lhr-solar/BPS-Leader/Hardware/ArrPreContactor.kicad_sch

## KiCad design Hardware/ArrPreContactor.kicad_sch (2026-01-18)

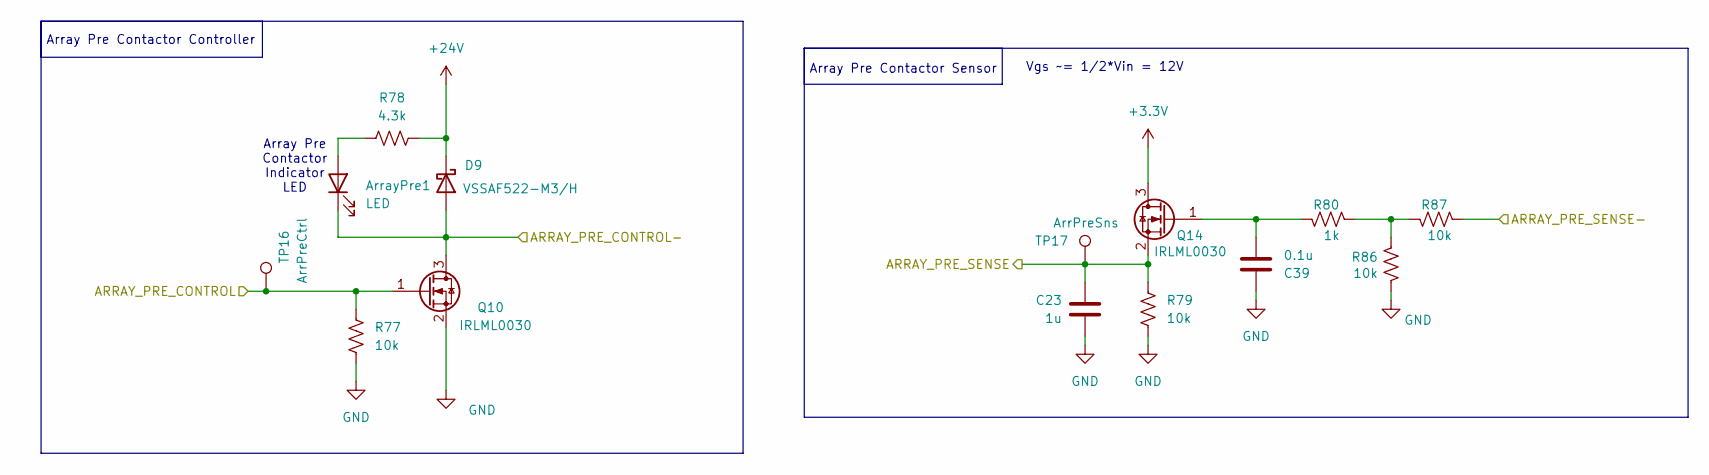
[picture p1: schematic ArrPreContactor.kicad_sch]

Parts:
ArrayPre1: LED; LED_0603_1608Metric; LCSC C84263
C23: 1u; C_0603_1608Metric; Mouser Part Number 963-UMK107BJ105KA-T
C39: 0.1u; C_0603_1608Metric; Mouser Part Number 963-HMK107B7104KA-T
D9: VSSAF522-M3/H; SODFL5226X100N; LCSC C6326606
Q10, Q14: IRLML0030; SOT-23; LCSC C67272
R77, R79, R86, R87: 10k; R_0603_1608Metric; LCSC C25804
R78: 4.3k; R_0603_1608Metric; LCSC C2907165
R80: 1k; R_0603_1608Metric; LCSC C21190
TP16: ArrPreCtrl; TestPoint_Pad_1.0x1.0mm
TP17: ArrPreSns; TestPoint_Pad_1.0x1.0mm

Connections:
+3.3V: Q14.3 (D)
+24V: D9.1 (K), R78.2
ARRAY_PRE_CONTROL: Q10.1 (G), R77.2, TP16.1
ARRAY_PRE_CONTROL-: ArrayPre1.1 (K), D9.2 (A), Q10.3 (D)
ARRAY_PRE_SENSE: C23.2, Q14.2 (S), R79.1, TP17.1
ARRAY_PRE_SENSE-: R87.2
GND: C23.1, C39.1, Q10.2 (S), R77.1, R79.2, R86.1
unnamed: ArrayPre1.2 (A), R78.1
unnamed: C39.2, Q14.1 (G), R80.1
unnamed: R80.2, R86.2, R87.1

Notes on the sheet:
Vgs ~= 1/2*Vin = 12V
Array Pre Contactor Controller
Array Pre Contactor Indicator LED
Array Pre Contactor Sensor
