lhr-solar/BPS-Leader/Hardware/Arr_Contactor.kicad_sch

## KiCad design Hardware/Arr_Contactor.kicad_sch (2026-01-18)

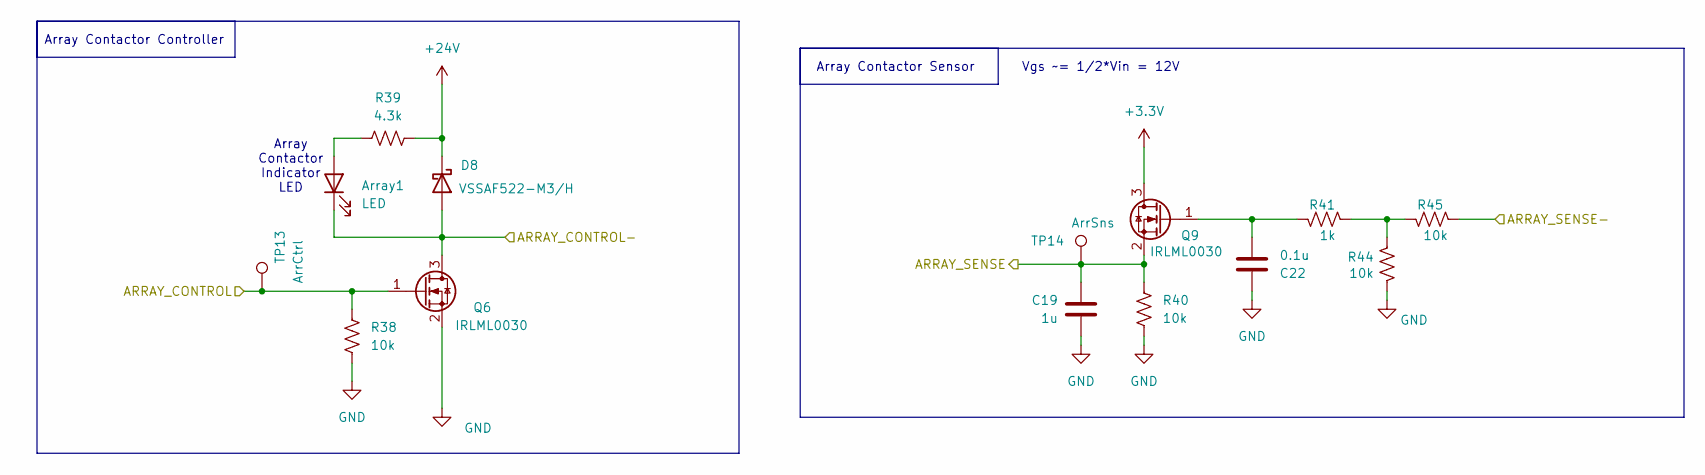
[picture p2: schematic Arr_Contactor.kicad_sch]

Parts:
Array1: LED; LED_0603_1608Metric; LCSC C84263
C19: 1u; C_0603_1608Metric; Mouser Part Number 963-UMK107BJ105KA-T
C22: 0.1u; C_0603_1608Metric; Mouser Part Number 963-HMK107B7104KA-T
D8: VSSAF522-M3/H; TO-247-2_Vertical; LCSC C6326606
Q6, Q9: IRLML0030; SOT-23; LCSC C67272
R38, R40, R44, R45: 10k; R_0603_1608Metric; LCSC C25804
R39: 4.3k; R_0603_1608Metric; LCSC C2907165
R41: 1k; R_0603_1608Metric; LCSC C21190
TP13: ArrCtrl; TestPoint_Pad_1.0x1.0mm
TP14: ArrSns; TestPoint_Pad_1.0x1.0mm

Connections:
+3.3V: Q9.3 (D)
+24V: D8.1 (K), R39.2
ARRAY_CONTROL: Q6.1 (G), R38.2, TP13.1
ARRAY_CONTROL-: Array1.1 (K), D8.2 (A), Q6.3 (D)
ARRAY_SENSE: C19.2, Q9.2 (S), R40.1, TP14.1
ARRAY_SENSE-: R45.2
GND: C19.1, C22.1, Q6.2 (S), R38.1, R40.2, R44.1
unnamed: Array1.2 (A), R39.1
unnamed: C22.2, Q9.1 (G), R41.1
unnamed: R41.2, R44.2, R45.1

Notes on the sheet:
Array Contactor Sensor
Vgs ~= 1/2*Vin = 12V
Array Contactor Controller
Array Contactor Indicator LED
