lhr-solar/BPS-Leader/Hardware/BPS-Leader.kicad_sch

## KiCad design Hardware/BPS-Leader.kicad_sch (2026-01-18)

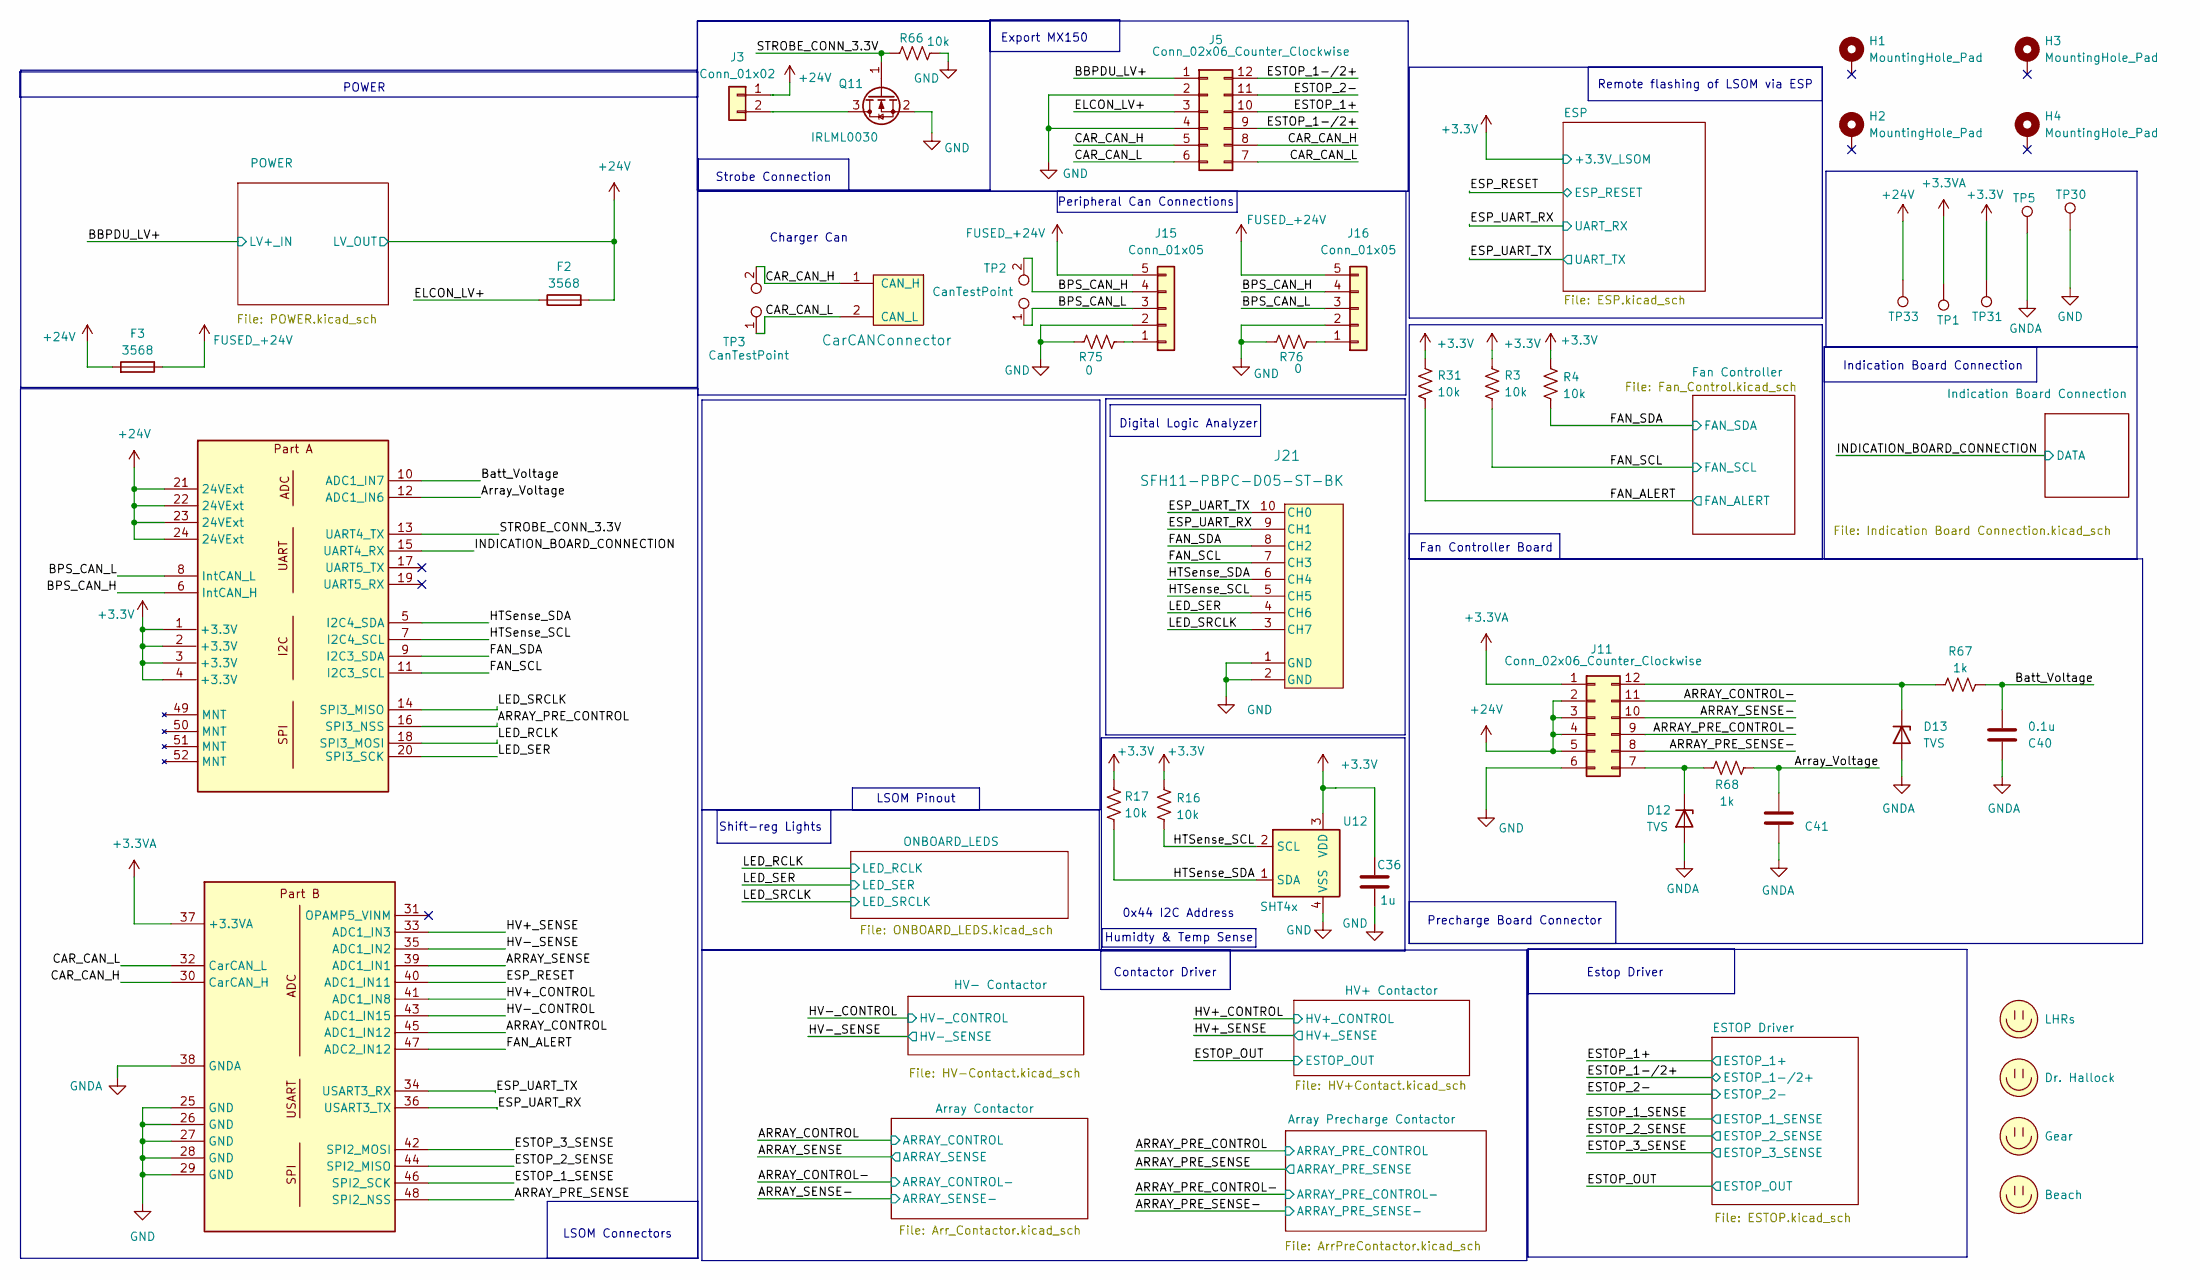
[picture p3: schematic BPS-Leader.kicad_sch]

Parts:
C36: 1u; C_0603_1608Metric; LCSC C15849
C40, C41: 0.1u; C_0603_1608Metric; Mouser Part Number 963-HMK107B7104KA-T
D12, D13: TVS; D_SOD-123F; Mouser Part Number 576-SMF3.3
F2, F3: 3568; LCSC C5249699
H1, H2, H3, H4: MountingHole_Pad; MountingHole_3.2mm_M3_Pad_TopBottom
J1: LeaderSOM
J3: Conn_01x02; Molex_Nano-Fit_105313-xx02_1x02_P2.50mm_Horizontal
J5, J11: Conn_02x06_Counter_Clockwise; Molex_Nano-Fit_105310-xx12_2x06_P2.50mm_Vertical
J8: CarCANConnector; Molex_Nano-Fit_105309-xx02_1x02_P2.50mm_Vertical
J15, J16: Conn_01x05; Molex_Nano-Fit_105309-xx05_1x05_P2.50mm_Vertical
J21: SFH11-PBPC-D05-ST-BK; CONN_SFH11-xxxC-D05-ST-XX_SUL
LOGO1: LHRs; LHRs_LOGO
LOGO2: Dr. Hallock; Hallock_Image
LOGO3: Beach
LOGO4: Gear
Q11: IRLML0030; SOT-23; LCSC C67272
R3, R4, R16, R17, R31, R66: 10k; R_0603_1608Metric; LCSC C25804
R67, R68: 1k; R_0603_1608Metric; Mouser Part Number 71-CRCW06031K00FKEI
R75, R76: 0; R_0603_1608Metric; LCSC C21189
TP1: +3.3VA; TestPoint_Keystone_5005-5009_Compact
TP2, TP3: CanTestPoint; PinHeader_1x02_P2.54mm_Vertical
TP5: GNDA; TestPoint_Keystone_5005-5009_Compact
TP30: GND; TestPoint_Keystone_5005-5009_Compact
TP31: +3.3V; TestPoint_Keystone_5005-5009_Compact
TP33: +24V; TestPoint_Keystone_5005-5009_Compact
U12: SHT4x; Sensirion_DFN-4_1.5x1.5mm_P0.8mm_SHT4x_NoCentralPad; LCSC C5221601

Connections:
+3.3V: C36.1, J1.1 (+3.3V), J1.2 (+3.3V), J1.3 (+3.3V), J1.4 (+3.3V), R3.1, R4.1, R16.1, R17.1, R31.1, TP31.1, U12.3 (VDD)
+3.3VA: J1.37 (+3.3VA), J11.1, TP1.1
+24V: F2.2, F3.2, J1.21 (24VExt), J1.22 (24VExt), J1.23 (24VExt), J1.24 (24VExt), J3.1, J11.2, J11.3, J11.4, J11.5, TP33.1
ARRAY_CONTROL: J1.45 (ADC1_IN12)
ARRAY_CONTROL-: J11.11
ARRAY_PRE_CONTROL: J1.16 (SPI3_NSS)
ARRAY_PRE_CONTROL-: J11.9
ARRAY_PRE_SENSE: J1.48 (SPI2_NSS)
ARRAY_PRE_SENSE-: J11.8
ARRAY_SENSE: J1.39 (ADC1_IN1)
ARRAY_SENSE-: J11.10
Array_Voltage: C41.2, J1.12 (ADC1_IN6), R68.1
BBPDU_LV+: J5.1
BPS_CAN_H: J1.6 (IntCAN_H), J15.4, J16.4, TP2.2
BPS_CAN_L: J1.8 (IntCAN_L), J15.3, J16.3, TP2.1
Batt_Voltage: C40.2, J1.10 (ADC1_IN7), R67.1
CAR_CAN_H: J1.30 (CarCAN_H), J5.5, J5.8, J8.1 (CAN_H), TP3.2
CAR_CAN_L: J1.32 (CarCAN_L), J5.6, J5.7, J8.2 (CAN_L), TP3.1
ELCON_LV+: F2.1, J5.3
ESP_RESET: J1.40 (ADC1_IN11)
ESP_UART_RX: J1.36 (USART3_TX), J21.9 (CH1)
ESP_UART_TX: J1.34 (USART3_RX), J21.10 (CH0)
ESTOP_1+: J5.10
ESTOP_1-/2+: J5.9, J5.12
ESTOP_1_SENSE: J1.46 (SPI2_SCK)
ESTOP_2-: J5.11
ESTOP_2_SENSE: J1.44 (SPI2_MISO)
ESTOP_3_SENSE: J1.42 (SPI2_MOSI)
FAN_ALERT: J1.47 (ADC2_IN12), R31.2
FAN_SCL: J1.11 (I2C3_SCL), J21.7 (CH3), R3.2
FAN_SDA: J1.9 (I2C3_SDA), J21.8 (CH2), R4.2
FUSED_+24V: F3.1, J15.5, J16.5
GND: C36.2, J1.25 (GND), J1.26 (GND), J1.27 (GND), J1.28 (GND), J1.29 (GND), J5.2, J5.4, J11.6, J15.2, J16.2, J21.1 (GND), J21.2 (GND), Q11.2 (S), R66.2, R75.1, R76.1, TP30.1, U12.4 (VSS)
GNDA: C40.1, C41.1, D12.2 (A), D13.2 (A), J1.38 (GNDA), TP5.1
HTSense_SCL: J1.7 (I2C4_SCL), J21.5 (CH5), R16.2, U12.2 (SCL)
HTSense_SDA: J1.5 (I2C4_SDA), J21.6 (CH4), R17.2, U12.1 (SDA)
HV+_CONTROL: J1.41 (ADC1_IN8)
HV+_SENSE: J1.33 (ADC1_IN3)
HV-_CONTROL: J1.43 (ADC1_IN15)
HV-_SENSE: J1.35 (ADC1_IN2)
INDICATION_BOARD_CONNECTION: J1.15 (UART4_RX)
LED_RCLK: J1.18 (SPI3_MOSI)
LED_SER: J1.20 (SPI3_SCK), J21.4 (CH6)
LED_SRCLK: J1.14 (SPI3_MISO), J21.3 (CH7)
unnamed: D12.1 (K), J11.7, R68.2
unnamed: D13.1 (K), J11.12, R67.2
unnamed: J3.2, Q11.3 (D)
unnamed: J15.1, R75.2
unnamed: J16.1, R76.2
STROBE_CONN_3.3V: J1.13 (UART4_TX), Q11.1 (G), R66.1

Notes on the sheet:
Contactor Driver
POWER
Estop Driver
Shift-reg Lights
Indication Board Connection
LSOM Pinout
Charger Can
Humidty & Temp Sense
Digital Logic Analyzer
Export MX150
Precharge Board Connector
0x44 I2C Address
Peripheral Can Connections
Remote flashing of LSOM via ESP
Strobe Connection
Fan Controller Board
LSOM Connectors
