lhr-solar/BPS-Leader/Hardware/Buttond_LEDs_IO.kicad_sch

## KiCad design Hardware/Buttond_LEDs_IO.kicad_sch (2026-01-18)

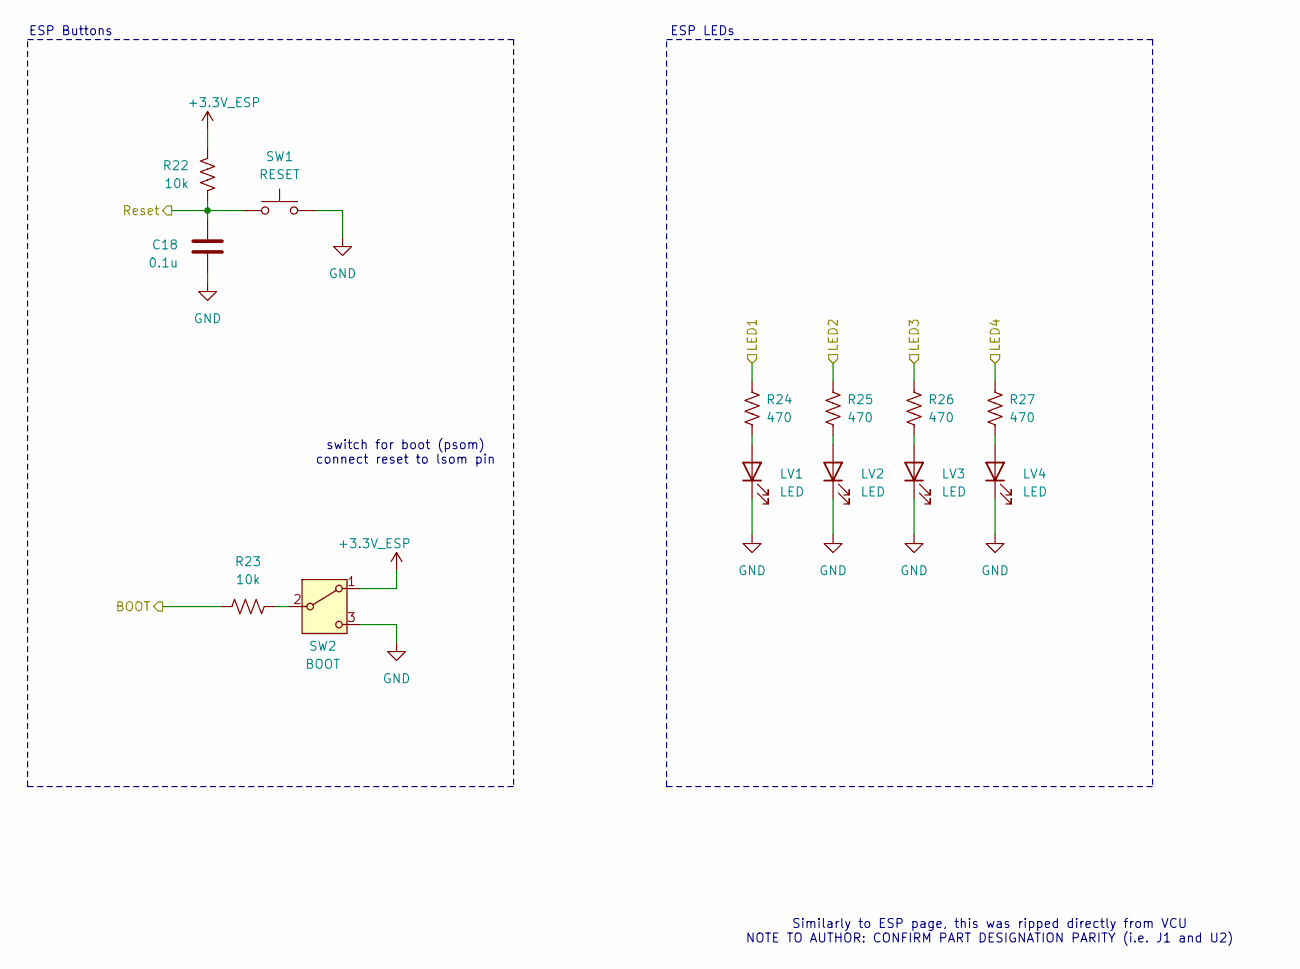
[picture p4: schematic Buttond_LEDs_IO.kicad_sch]

Parts:
C18: 0.1u; C_0603_1608Metric; LCSC C14663
LV1, LV2, LV3, LV4: LED; LED_0603_1608Metric; LCSC C7371904
R22, R23: 10k; R_0603_1608Metric; LCSC C25804
R24, R25, R26, R27: 470; R_0603_1608Metric; LCSC C23179
SW1: RESET; TL3365AF180QG; LCSC C2886926
SW2: BOOT; SW_CJS-1200TA; LCSC C2921628

Connections:
+3.3V_ESP: R22.1, SW2.1 (A)
BOOT: R23.2
GND: C18.2, LV1.1 (K), LV2.1 (K), LV3.1 (K), LV4.1 (K), SW1.1 (A), SW1.2 (A), SW2.3 (C)
LED1: R24.1
LED2: R25.1
LED3: R26.1
LED4: R27.1
unnamed: LV1.2 (A), R24.2
unnamed: LV2.2 (A), R25.2
unnamed: LV3.2 (A), R26.2
unnamed: LV4.2 (A), R27.2
unnamed: R23.1, SW2.2 (B)
Reset: C18.1, R22.2, SW1.3 (B), SW1.4 (B)

Notes on the sheet:
switch for boot (psom) connect reset to lsom pin
Similarly to ESP page, this was ripped directly from VCU NOTE TO AUTHOR: CONFIRM PART DESIGNATION PARITY (i.e. J1 and U2)
ESP Buttons
ESP LEDs
