lhr-solar/BPS-Leader/Hardware/ESP.kicad_sch

## KiCad design Hardware/ESP.kicad_sch (2026-01-18)

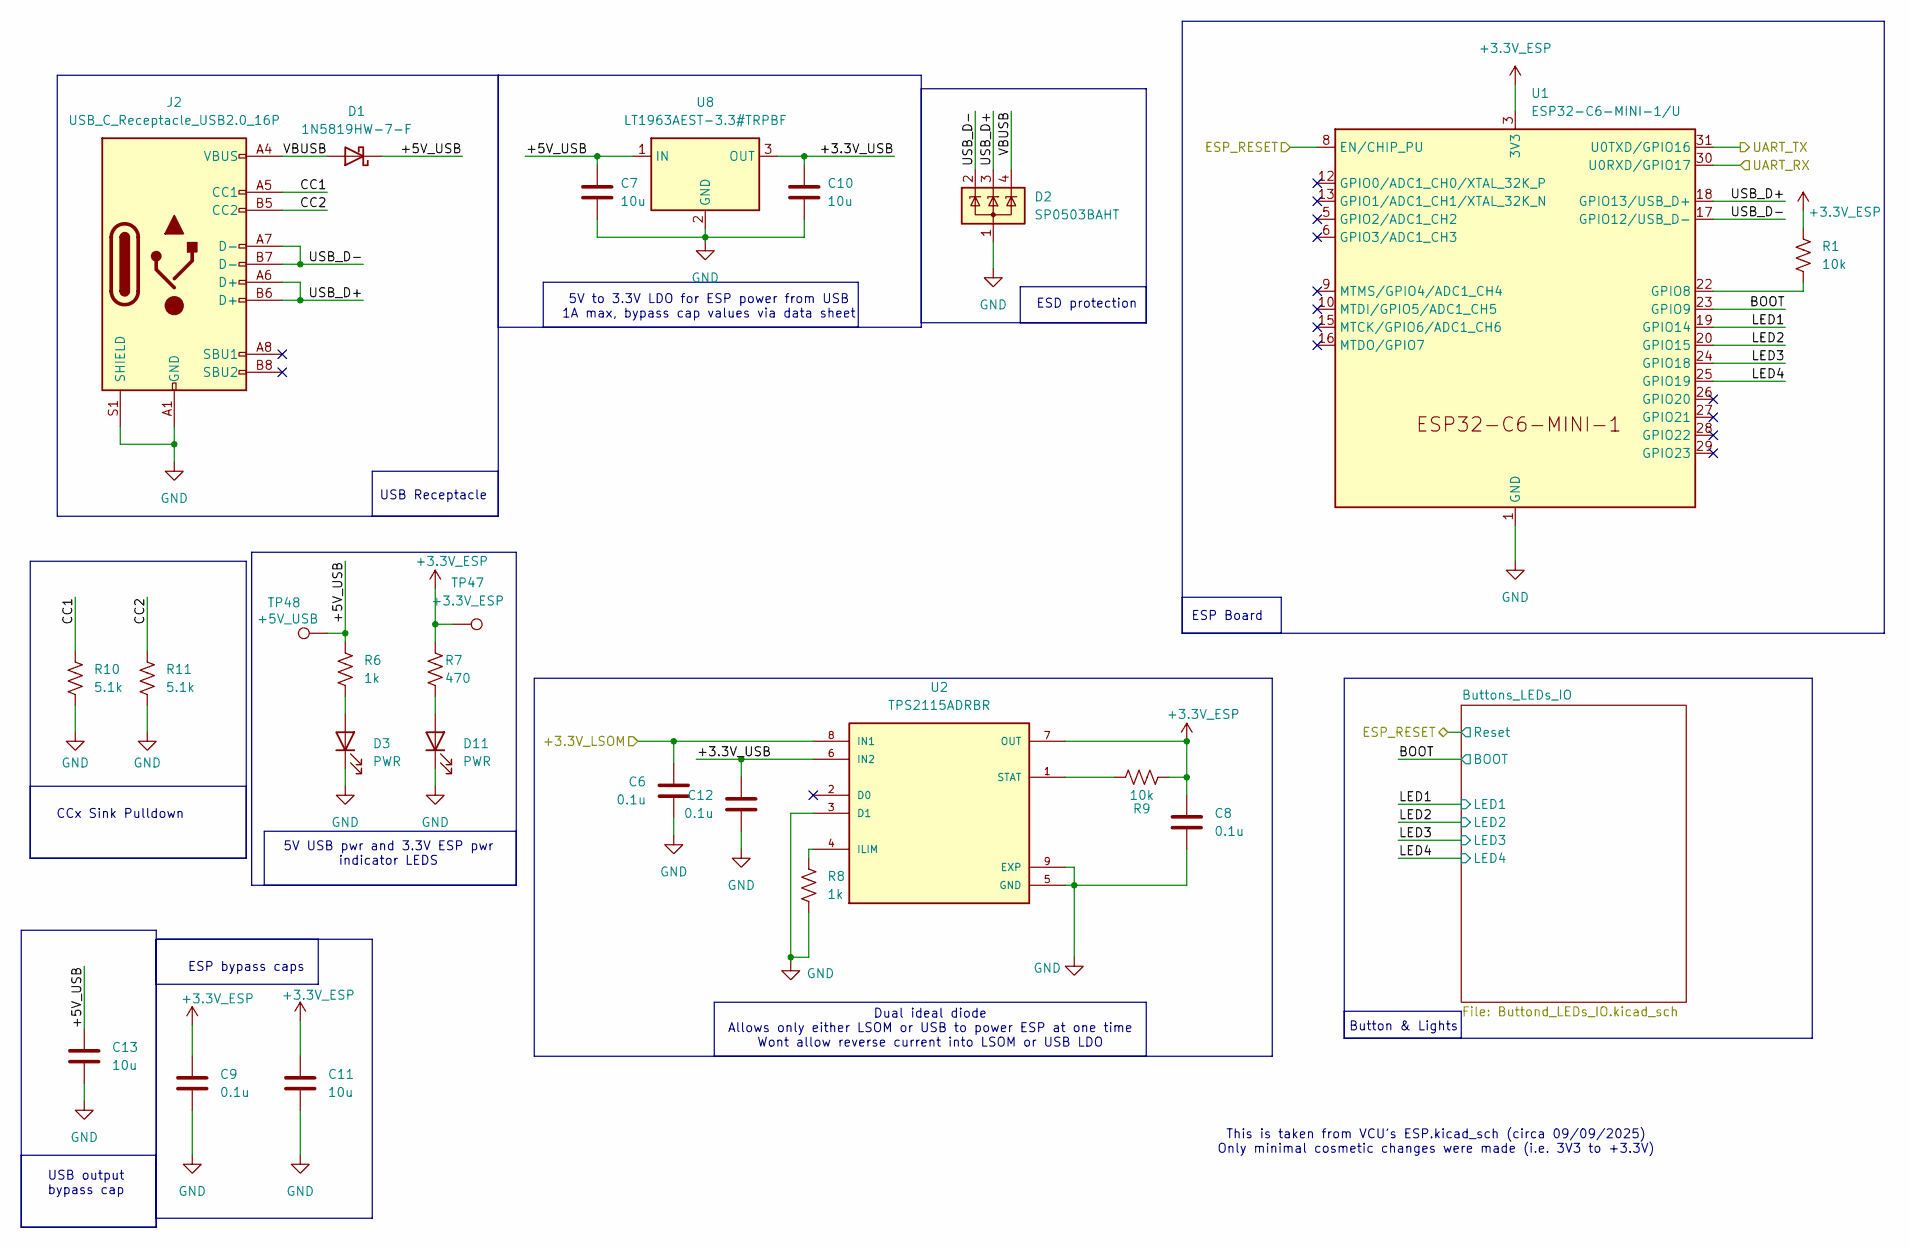
[picture p5: schematic ESP.kicad_sch]

Parts:
C6, C8, C9, C12: 0.1u; C_0603_1608Metric; LCSC C14663
C7, C10, C11, C13: 10u; C_0805_2012Metric; LCSC C440198
D1: 1N5819HW-7-F; D_SOD-123; LCSC C82544
D2: SP0503BAHT; SOT-143; Mouser Part Number 576-SP0503BAHTG
D3, D11: PWR; LED_0603_1608Metric; LCSC C7371904
J2: USB_C_Receptacle_USB2.0_16P; USB_C_Receptacle_GCT_USB4105-xx-A_16P_TopMnt_Horizontal; LCSC C393939
R1, R9: 10k; R_0603_1608Metric; LCSC C25804
R6, R8: 1k; R_0603_1608Metric; LCSC C21190
R7: 470; R_0603_1608Metric; LCSC C23179
R10, R11: 5.1k; R_0603_1608Metric; LCSC C23186
TP47: +3.3V_ESP; TestPoint_Keystone_5005-5009_Compact
TP48: +5V_USB; TestPoint_Keystone_5005-5009_Compact
U1: ESP32-C6-MINI-1/U; ESP32-C6-MINI-1; LCSC C5736265
U2: TPS2115ADRBR; SON65P300X300X100-9N; LCSC C140321
U8: LT1963AEST-3.3#TRPBF; SOT-223-3_TabPin2; LCSC C145411

Connections:
+3.3V_ESP: C8.1, C9.1, C11.1, R1.1, R7.1, R9.1, TP47.1, U1.3 (3V3), U2.7 (OUT)
+3.3V_LSOM: C6.1, U2.8 (IN1)
+3.3V_USB: C10.1, C12.1, U2.6 (IN2), U8.3 (OUT)
+5V_USB: C7.1, C13.1, D1.1 (K), R6.1, TP48.1, U8.1 (IN)
BOOT: U1.23 (GPIO9)
CC1: J2.A5 (CC1), R10.1
CC2: J2.B5 (CC2), R11.1
ESP_RESET: U1.8 (EN/CHIP_PU)
GND: C6.2, C7.2, C8.2, C9.2, C10.2, C11.2, C12.2, C13.2, D2.1 (A), D3.1 (K), D11.1 (K), J2.A1 (GND), J2.A12 (GND), J2.B1 (GND), J2.B12 (GND), J2.S1 (SHIELD), R8.2, R10.2, R11.2, U1.1 (GND), U1.2 (GND), U1.11 (GND), U1.14 (GND), U1.36 (GND), U1.37 (GND), U1.38 (GND), U1.39 (GND), U1.40 (GND), U1.41 (GND), U1.42 (GND), U1.43 (GND), U1.44 (GND), U1.45 (GND), U1.46 (GND), U1.47 (GND), U1.48 (GND), U1.49 (GND), U1.50 (GND), U1.51 (GND), U1.52 (GND), U1.53 (GND), U2.3 (D1), U2.5 (GND), U2.9 (EXP), U8.2 (GND)
LED1: U1.19 (GPIO14)
LED2: U1.20 (GPIO15)
LED3: U1.24 (GPIO18)
LED4: U1.25 (GPIO19)
unnamed: D3.2 (A), R6.2
unnamed: D11.2 (A), R7.2
unnamed: R1.2, U1.22 (GPIO8)
unnamed: R8.1, U2.4 (ILIM)
unnamed: R9.2, U2.1 (STAT)
UART_RX: U1.30 (U0RXD/GPIO17)
UART_TX: U1.31 (U0TXD/GPIO16)
USB_D+: D2.3 (K), J2.A6 (D+), J2.B6 (D+), U1.18 (GPIO13/USB_D+)
USB_D-: D2.2 (K), J2.A7 (D-), J2.B7 (D-), U1.17 (GPIO12/USB_D-)
VBUSB: D1.2 (A), D2.4 (K), J2.A4 (VBUS), J2.A9 (VBUS), J2.B4 (VBUS), J2.B9 (VBUS)

Notes on the sheet:
ESP bypass caps
ESD protection
USB Receptacle
5V USB pwr and 3.3V ESP pwr indicator LEDS
This is taken from VCU's ESP.kicad_sch (circa 09/09/2025) Only minimal cosmetic changes were made (i.e. 3V3 to +3.3V)
Dual ideal diode Allows only either LSOM or USB to power ESP at one time Wont allow reverse current into LSOM or USB LDO
USB output bypass cap
Button & Lights
ESP Board
CCx Sink Pulldown
5V to 3.3V LDO for ESP power from USB 1A max, bypass cap values via data sheet
