lhr-solar/BPS-Leader/Hardware/ESTOP.kicad_sch

## KiCad design Hardware/ESTOP.kicad_sch (2026-01-18)

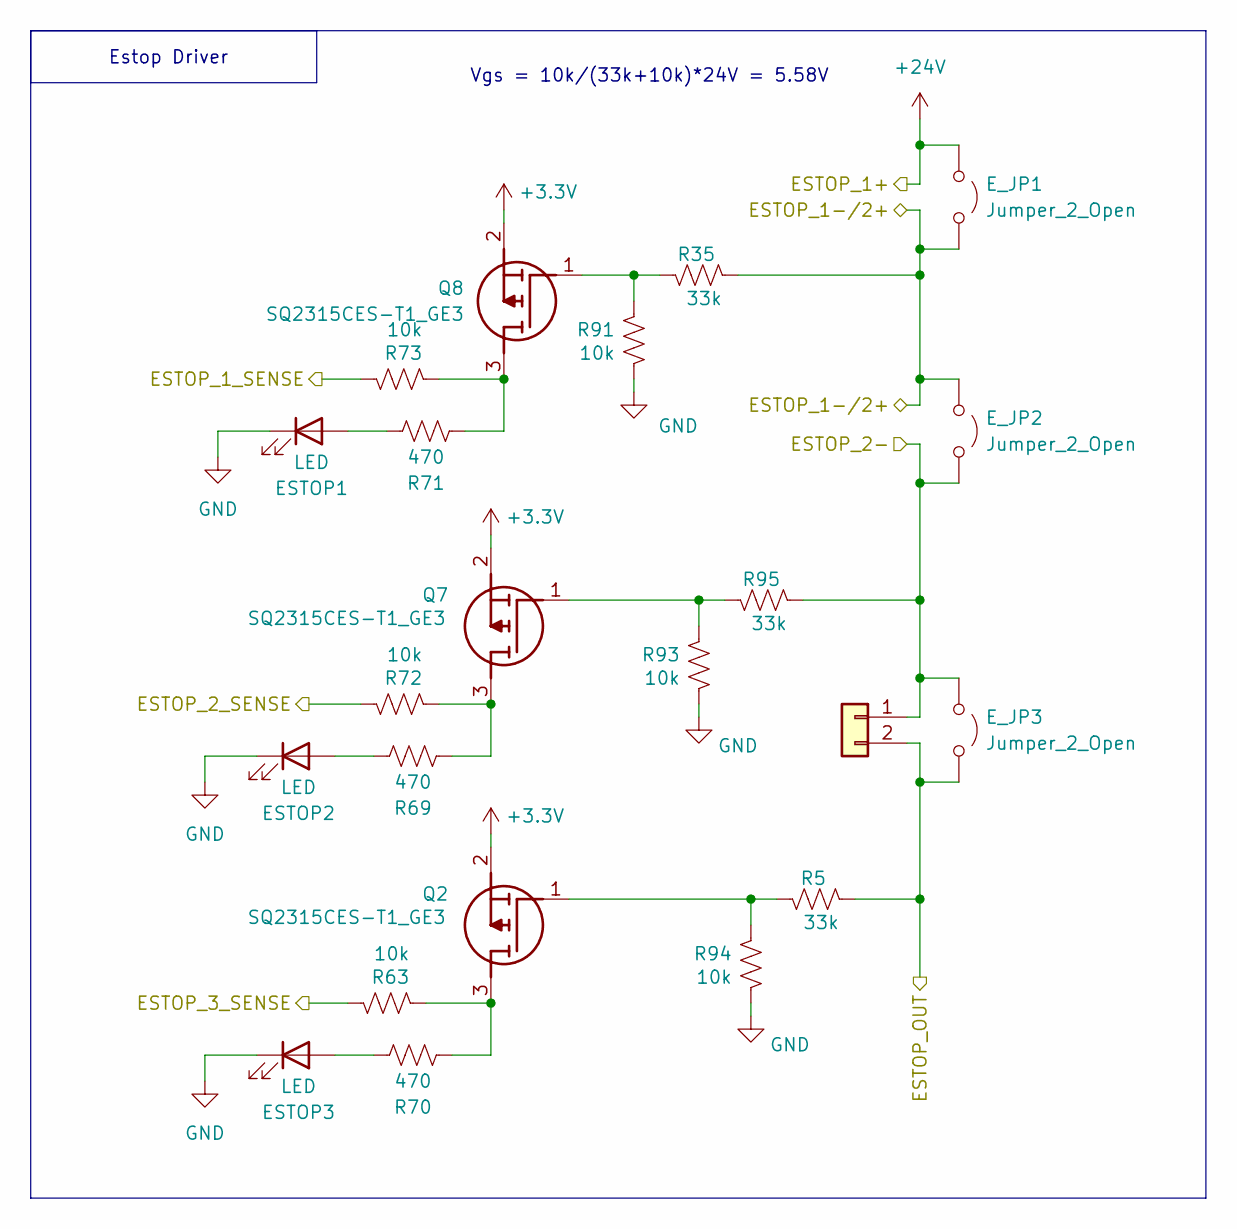
[picture p6: schematic ESTOP.kicad_sch]

Parts:
ESTOP1, ESTOP2, ESTOP3: LED; LED_0603_1608Metric; LCSC C84263
E_JP1, E_JP2, E_JP3: Jumper_2_Open; PinHeader_1x02_P2.54mm_Vertical
J10: Conn_01x02; Molex_Nano-Fit_105309-xx02_1x02_P2.50mm_Vertical
Q2, Q7, Q8: SQ2315CES-T1_GE3; SOT95P237X112-3N; Mouser Part Number 78-SQ2315CES-T1_GE3
R5, R35, R95: 33k; R_0603_1608Metric; LCSC C844778
R63, R72, R73, R91, R93, R94: 10k; R_0603_1608Metric; LCSC C25804
R69, R70, R71: 470; R_0603_1608Metric; LCSC C23179

Connections:
+3.3V: Q2.2 (S), Q7.2 (S), Q8.2 (S)
+24V: E_JP1.1 (A)
ESTOP_1-/2+: E_JP1.2 (B), E_JP2.1 (A), R35.2
ESTOP_1_SENSE: R73.2
ESTOP_2-: E_JP2.2 (B), E_JP3.1 (A), J10.1, R95.2
ESTOP_2_SENSE: R72.2
ESTOP_3_SENSE: R63.2
ESTOP_OUT: E_JP3.2 (B), J10.2, R5.2
GND: ESTOP1.1 (K), ESTOP2.1 (K), ESTOP3.1 (K), R91.1, R93.1, R94.1
unnamed: ESTOP1.2 (A), R71.2
unnamed: ESTOP2.2 (A), R69.2
unnamed: ESTOP3.2 (A), R70.2
unnamed: Q2.1 (G), R5.1, R94.2
unnamed: Q2.3 (D), R63.1, R70.1
unnamed: Q7.1 (G), R93.2, R95.1
unnamed: Q7.3 (D), R69.1, R72.1
unnamed: Q8.1 (G), R35.1, R91.2
unnamed: Q8.3 (D), R71.1, R73.1

Notes on the sheet:
Vgs = 10k/(33k+10k)*24V = 5.58V
Estop Driver
