lhr-solar/BPS-Leader/Hardware/Fan_Control.kicad_sch

## KiCad design Hardware/Fan_Control.kicad_sch (2026-01-18)

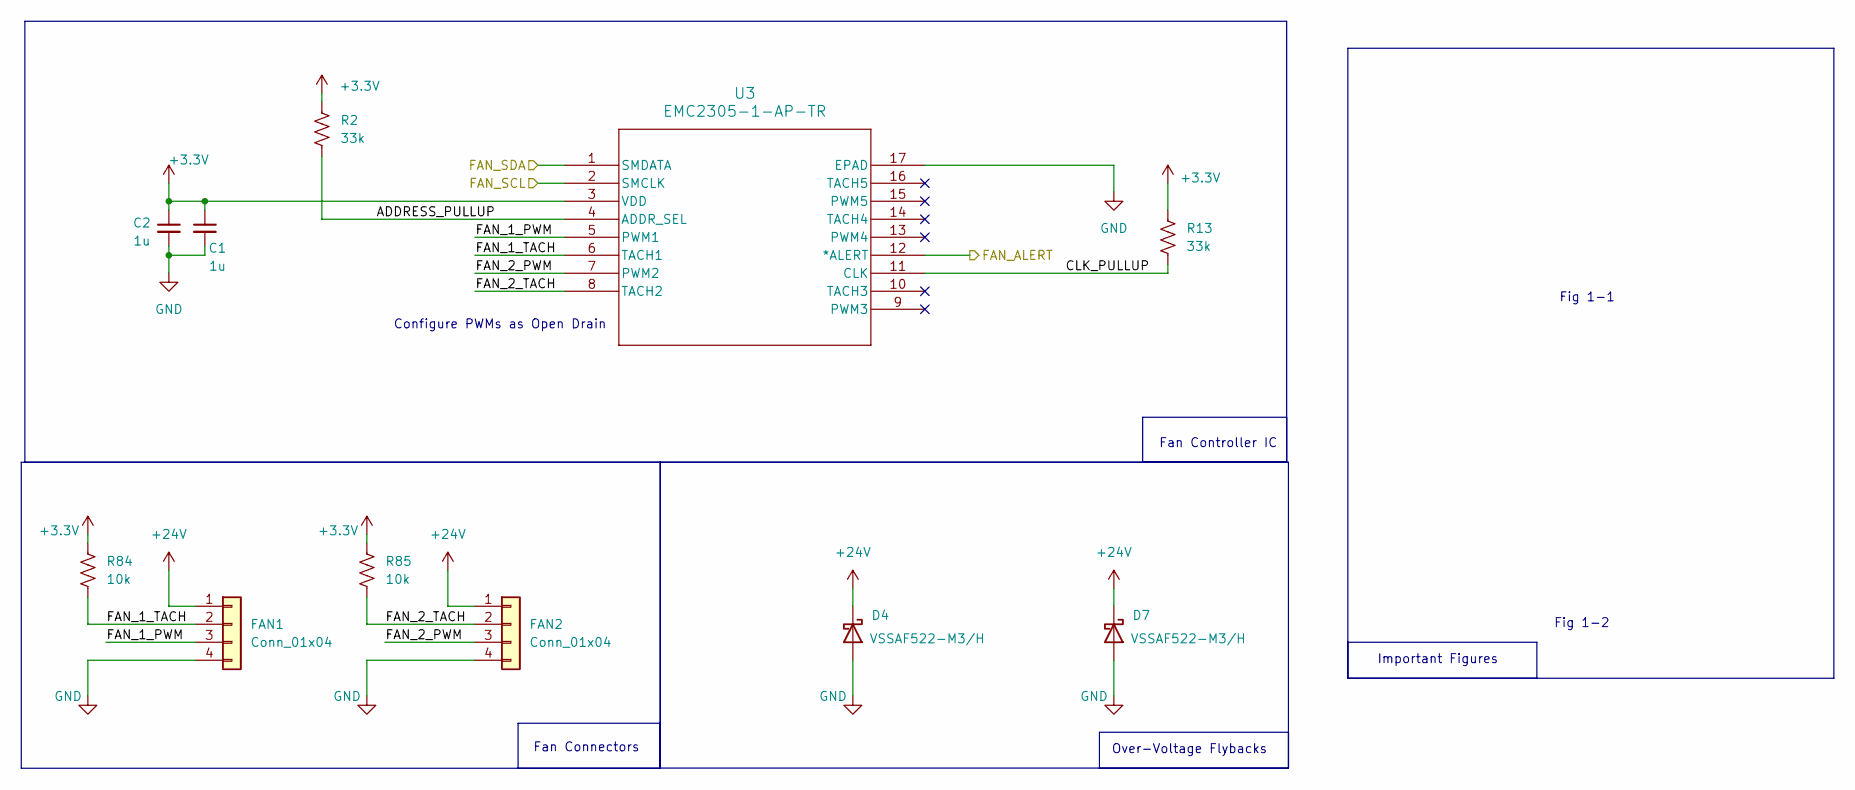
[picture p7: schematic Fan_Control.kicad_sch]

Parts:
C1, C2: 1u; C_0603_1608Metric; LCSC C15849
D4, D7: VSSAF522-M3/H; SODFL5226X100N; LCSC C6326606
FAN1, FAN2: Conn_01x04; Molex_Nano-Fit_105309-xx04_1x04_P2.50mm_Vertical
R2, R13: 33k; R_0603_1608Metric; LCSC C844778
R84, R85: 10k; R_0603_1608Metric; LCSC C25804
U3: EMC2305-1-AP-TR; QFN65P400X400X90-17N-D; LCSC C621415

Connections:
+3.3V: C1.1, C2.1, R2.1, R13.1, R84.1, R85.1, U3.3 (VDD)
+24V: D4.1 (K), D7.1 (K), FAN1.1, FAN2.1
ADDRESS_PULLUP: R2.2, U3.4 (ADDR_SEL)
CLK_PULLUP: R13.2, U3.11 (CLK)
FAN_1_PWM: FAN1.3, U3.5 (PWM1)
FAN_1_TACH: FAN1.2, R84.2, U3.6 (TACH1)
FAN_2_PWM: FAN2.3, U3.7 (PWM2)
FAN_2_TACH: FAN2.2, R85.2, U3.8 (TACH2)
FAN_ALERT: U3.12 (*ALERT)
FAN_SCL: U3.2 (SMCLK)
FAN_SDA: U3.1 (SMDATA)
GND: C1.2, C2.2, D4.2 (A), D7.2 (A), FAN1.4, FAN2.4, U3.17 (EPAD)

Notes on the sheet:
Fan Controller IC
Fan Connectors
Over-Voltage Flybacks
Fig 1-1
Configure PWMs as Open Drain
Fig 1-2
Important Figures
