lhr-solar/BPS-Leader/Hardware/HV+Contact.kicad_sch

## KiCad design Hardware/HV+Contact.kicad_sch (2026-01-18)

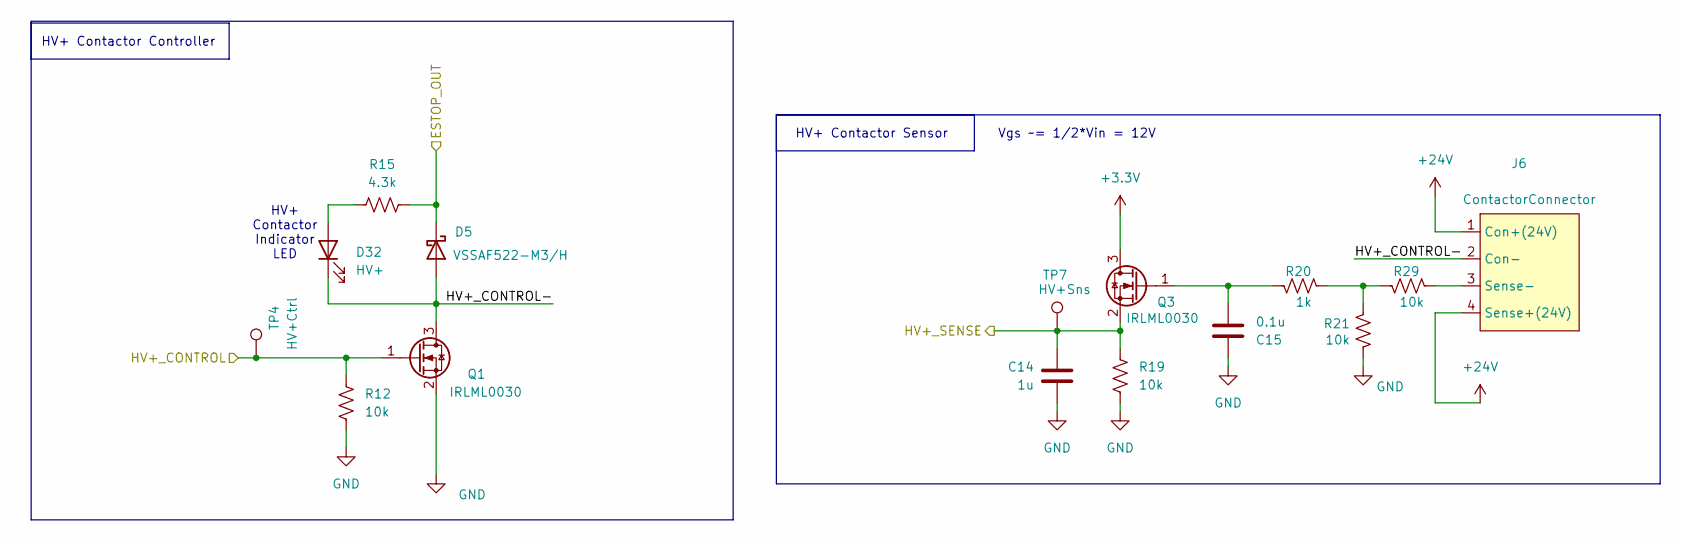
[picture p8: schematic HV+Contact.kicad_sch]

Parts:
C14: 1u; C_0603_1608Metric; Mouser Part Number 963-UMK107BJ105KA-T
C15: 0.1u; C_0603_1608Metric; Mouser Part Number 963-HMK107B7104KA-T
D5: VSSAF522-M3/H; SODFL5226X100N; LCSC C6326606
D32: HV+; LED_0603_1608Metric; LCSC C84263
J6: ContactorConnector; Molex_Nano-Fit_105309-xx04_1x04_P2.50mm_Vertical
Q1, Q3: IRLML0030; SOT-23; LCSC C67272
R12, R19, R21, R29: 10k; R_0603_1608Metric; LCSC C25804
R15: 4.3k; R_0603_1608Metric; LCSC C2907165
R20: 1k; R_0603_1608Metric; LCSC C21190
TP4: HV+Ctrl; TestPoint_Pad_1.0x1.0mm
TP7: HV+Sns; TestPoint_Pad_1.0x1.0mm

Connections:
+3.3V: Q3.3 (D)
+24V: J6.1 (Con+(24V)), J6.4 (Sense+(24V))
ESTOP_OUT: D5.1 (K), R15.2
GND: C14.1, C15.1, Q1.2 (S), R12.1, R19.2, R21.1
HV+_CONTROL: Q1.1 (G), R12.2, TP4.1
HV+_CONTROL-: D5.2 (A), D32.1 (K), J6.2 (Con-), Q1.3 (D)
HV+_SENSE: C14.2, Q3.2 (S), R19.1, TP7.1
unnamed: C15.2, Q3.1 (G), R20.1
unnamed: D32.2 (A), R15.1
unnamed: J6.3 (Sense-), R29.2
unnamed: R20.2, R21.2, R29.1

Notes on the sheet:
HV+ Contactor Indicator LED
HV+ Contactor Controller
HV+ Contactor Sensor
Vgs ~= 1/2*Vin = 12V
