lhr-solar/BPS-Leader/Hardware/HV-Contact.kicad_sch

## KiCad design Hardware/HV-Contact.kicad_sch (2026-01-18)

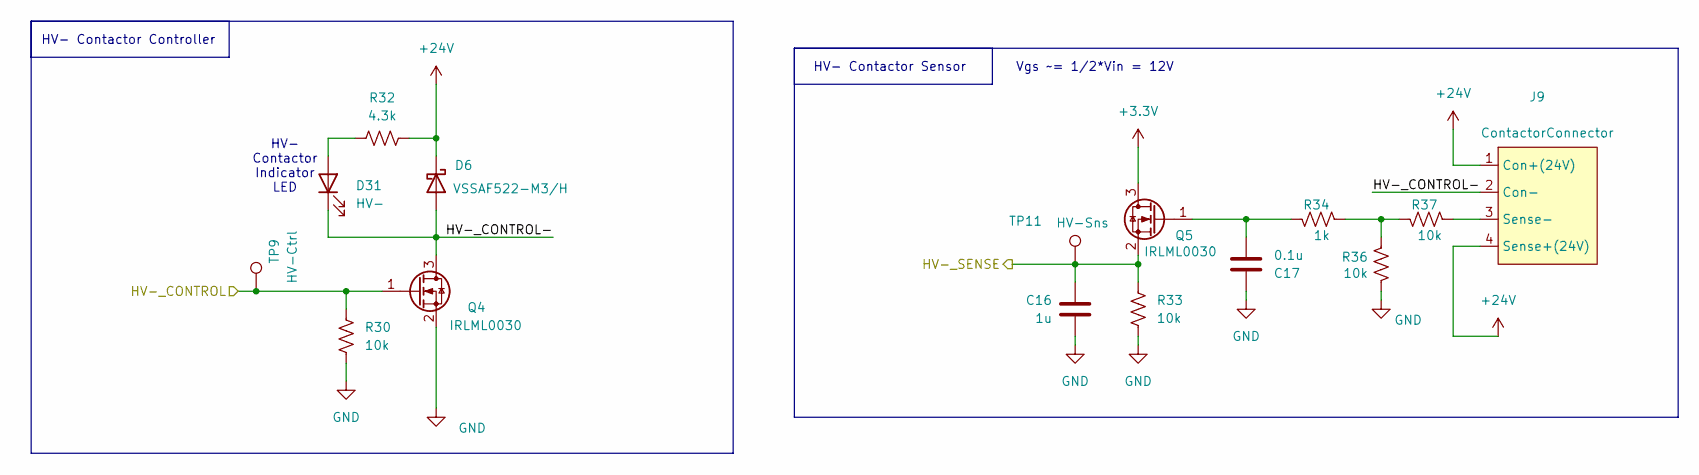
[picture p9: schematic HV-Contact.kicad_sch]

Parts:
C16: 1u; C_0603_1608Metric; Mouser Part Number 963-UMK107BJ105KA-T
C17: 0.1u; C_0603_1608Metric; Mouser Part Number 963-HMK107B7104KA-T
D6: VSSAF522-M3/H; SODFL5226X100N; LCSC C6326606
D31: HV-; LED_0603_1608Metric; LCSC C84263
J9: ContactorConnector; Molex_Nano-Fit_105309-xx04_1x04_P2.50mm_Vertical
Q4, Q5: IRLML0030; SOT-23; LCSC C67272
R30, R33, R36, R37: 10k; R_0603_1608Metric; LCSC C25804
R32: 4.3k; R_0603_1608Metric; LCSC C2907165
R34: 1k; R_0603_1608Metric; LCSC C21190
TP9: HV-Ctrl; TestPoint_Pad_1.0x1.0mm
TP11: HV-Sns; TestPoint_Pad_1.0x1.0mm

Connections:
+3.3V: Q5.3 (D)
+24V: D6.1 (K), J9.1 (Con+(24V)), J9.4 (Sense+(24V)), R32.2
GND: C16.1, C17.1, Q4.2 (S), R30.1, R33.2, R36.1
HV-_CONTROL: Q4.1 (G), R30.2, TP9.1
HV-_CONTROL-: D6.2 (A), D31.1 (K), J9.2 (Con-), Q4.3 (D)
HV-_SENSE: C16.2, Q5.2 (S), R33.1, TP11.1
unnamed: C17.2, Q5.1 (G), R34.1
unnamed: D31.2 (A), R32.1
unnamed: J9.3 (Sense-), R37.2
unnamed: R34.2, R36.2, R37.1

Notes on the sheet:
HV- Contactor Controller
HV- Contactor Indicator LED
HV- Contactor Sensor
Vgs ~= 1/2*Vin = 12V
