lhr-solar/BPS-Leader/Hardware/Indication Board Connection.kicad_sch

## KiCad design Hardware/Indication Board Connection.kicad_sch (2026-01-18)

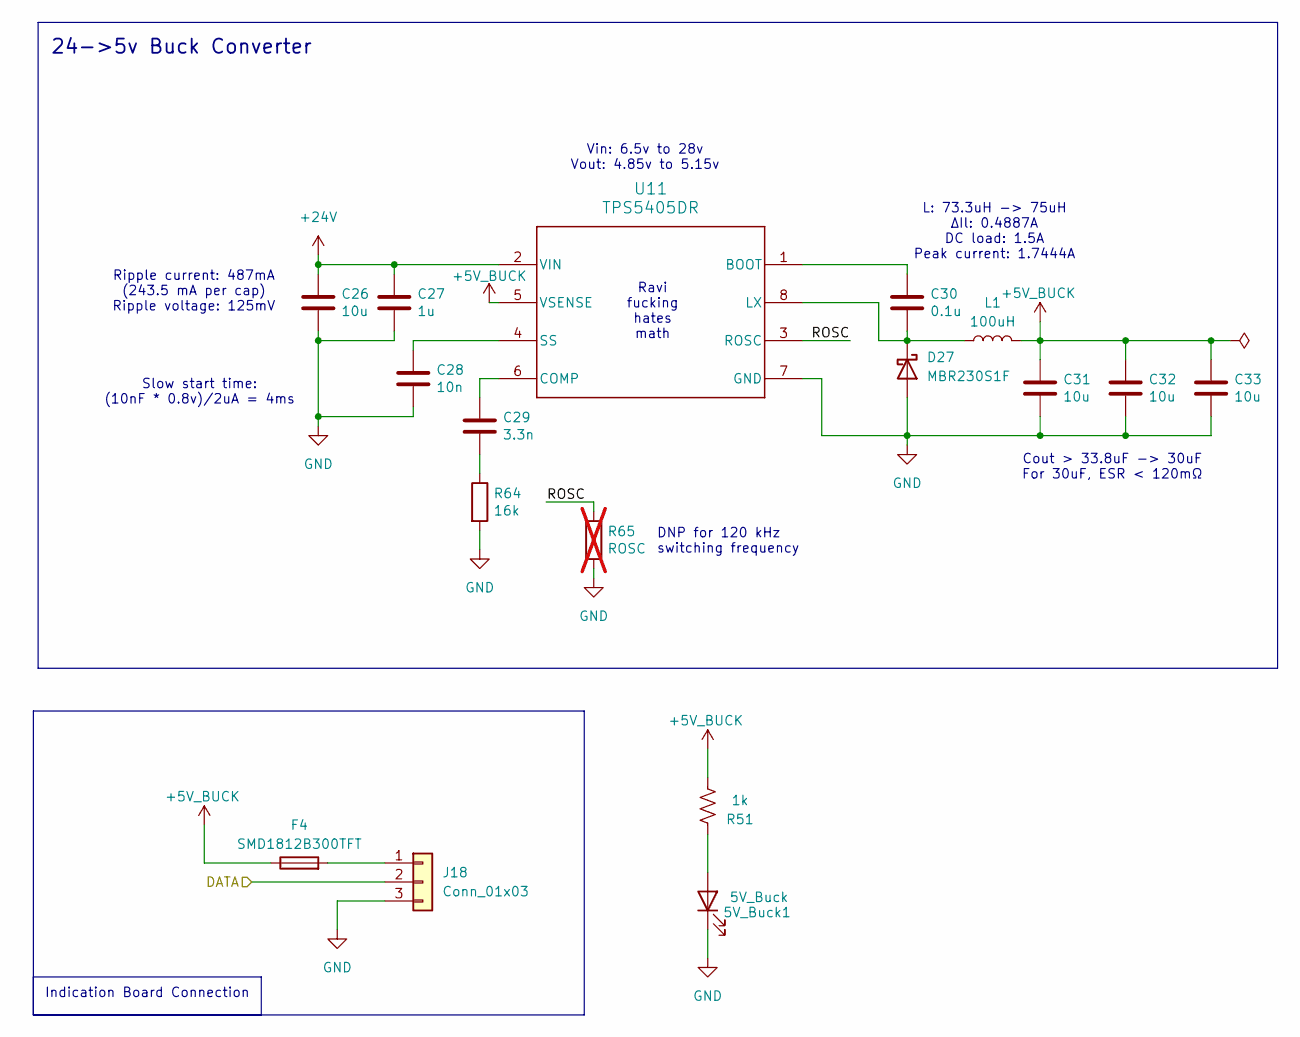
[picture p10: schematic Indication Board Connection.kicad_sch]

Parts:
5V_Buck1: 5V_Buck; LED_0603_1608Metric; LCSC C7371904
C26, C31, C32, C33: 10u; C_0805_2012Metric; LCSC C440198
C27: 1u; C_0603_1608Metric; LCSC C15849
C28: 10n; C_0603_1608Metric; LCSC C57112
C29: 3.3n; C_0603_1608Metric; LCSC C107088
C30: 0.1u; C_0603_1608Metric; LCSC C14663
D27: MBR230S1F; D_SOD-123F; LCSC C41408002
F4: SMD1812B300TFT; FUSC4632X165N; Mouser Part Number 603-SMD1812B300TFT
J18: Conn_01x03; Molex_Nano-Fit_105309-xx03_1x03_P2.50mm_Vertical
L1: 100uH; L_Coilcraft_MSS1246-XXX
R51: 1k; R_0603_1608Metric; Mouser Part Number 71-CRCW06031K00FKEI
R64: 16k; R_0603_1608Metric; LCSC C137788
R65: ROSC; R_0603_1608Metric; not fitted
U11: TPS5405DR; LCSC C488409

Connections:
+5V_BUCK: C31.1, C32.1, C33.1, F4.1, L1.2, R51.1, U11.5 (VSENSE)
+24V: C26.1, C27.1, U11.2 (VIN)
DATA: J18.2
GND: 5V_Buck1.1 (K), C26.2, C27.2, C28.2, C31.2, C32.2, C33.2, D27.2 (A), J18.3, R64.2, R65.2, U11.7 (GND)
unnamed: 5V_Buck1.2 (A), R51.2
unnamed: C28.1, U11.4 (SS)
unnamed: C29.1, U11.6 (COMP)
unnamed: C29.2, R64.1
unnamed: C30.1, U11.1 (BOOT)
unnamed: C30.2, D27.1 (K), L1.1, U11.8 (LX)
unnamed: F4.2, J18.1
ROSC: R65.1, U11.3 (ROSC)

Notes on the sheet:
Cout > 33.8uF -> 30uF For 30uF, ESR < 120mΩ
L: 73.3uH -> 75uH ΔIl: 0.4887A DC load: 1.5A Peak current: 1.7444A
24->5v Buck Converter
DNP for 120 kHz switching frequency
Slow start time: (10nF * 0.8v)/2uA = 4ms
Ravi fucking hates math
Vin: 6.5v to 28v Vout: 4.85v to 5.15v
Ripple current: 487mA (243.5 mA per cap) Ripple voltage: 125mV
Indication Board Connection
