lhr-solar/BPS-Leader/Hardware/ONBOARD_LEDS.kicad_sch

## KiCad design Hardware/ONBOARD_LEDS.kicad_sch (2026-01-18)

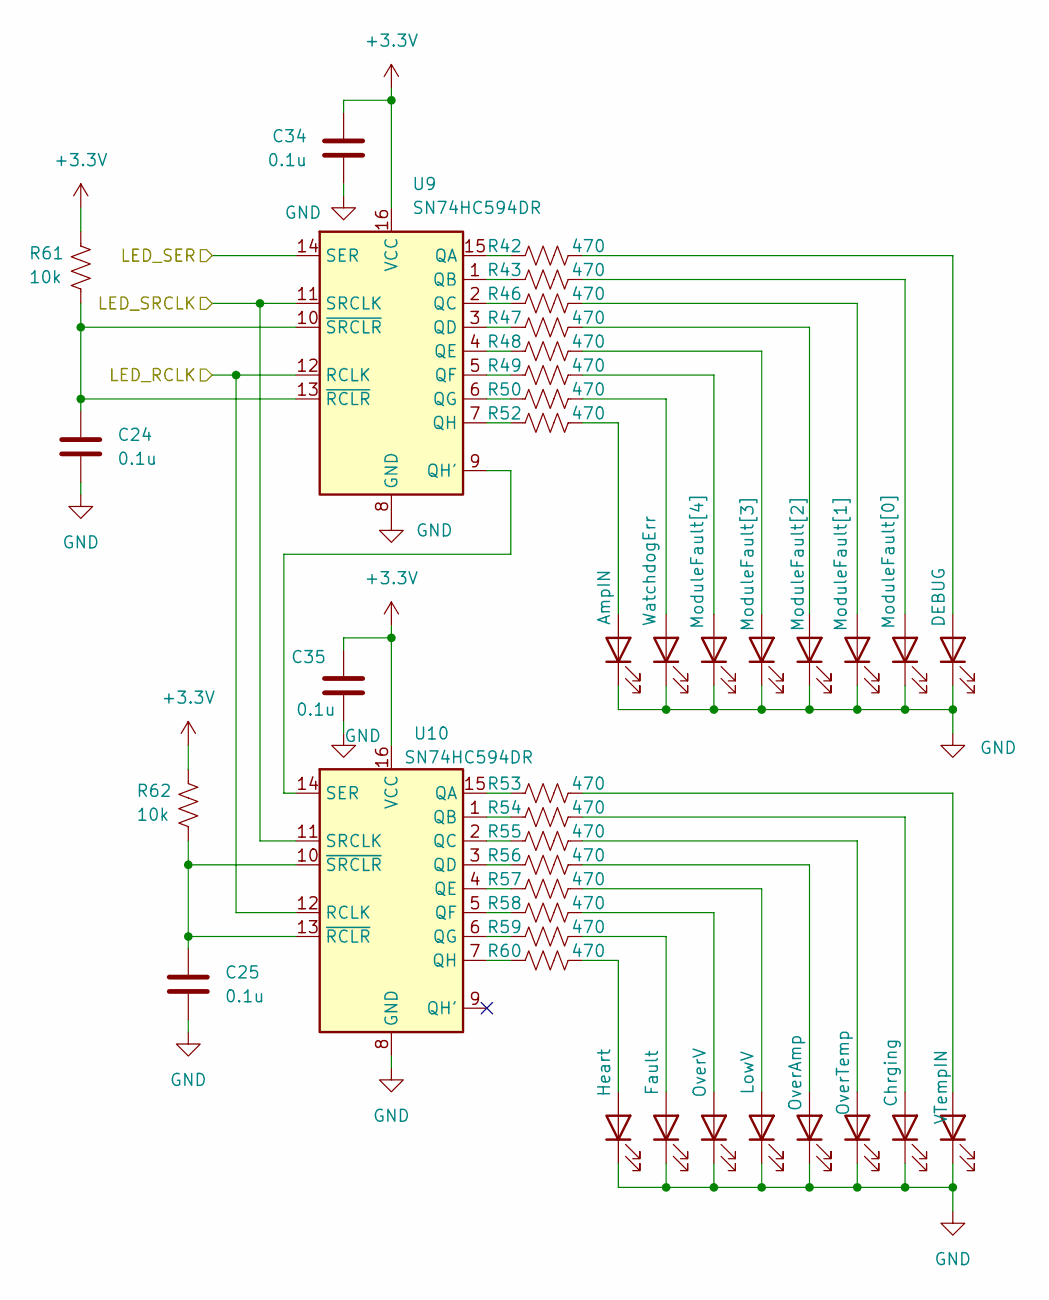
[picture p11: schematic ONBOARD_LEDS.kicad_sch]

Parts:
C24, C25, C34, C35: 0.1u; C_0603_1608Metric; LCSC C14663
D14: DEBUG; LED_0603_1608Metric; LCSC C84263
D15: ModuleFault[0]; LED_0603_1608Metric; LCSC C7371904
D16: ModuleFault[1]; LED_0603_1608Metric; LCSC C7371904
D17: ModuleFault[2]; LED_0603_1608Metric; LCSC C7371904
D18: ModuleFault[3]; LED_0603_1608Metric; LCSC C7371904
D19: ModuleFault[4]; LED_0603_1608Metric; LCSC C7371904
D20: WatchdogErr; LED_0603_1608Metric; LCSC C84263
D21: AmpIN; LED_0603_1608Metric; LCSC C84263
D22: VTempIN; LED_0603_1608Metric; LCSC C84263
D23: Chrging; LED_0603_1608Metric; LCSC C84263
D24: OverTemp; LED_0603_1608Metric; LCSC C84263
D25: OverAmp; LED_0603_1608Metric; LCSC C84263
D26: LowV; LED_0603_1608Metric; LCSC C84263
D28: Fault; LED_0603_1608Metric; LCSC C84263
D29: Heart; LED_0603_1608Metric; LCSC C84263
D30: OverV; LED_0603_1608Metric; LCSC C84263
R42, R43, R46, R47, R48, R49, R50, R52, R53, R54, R55, R56, R57, R58, R59, R60: 470; R_0603_1608Metric; LCSC C23179
R61, R62: 10k; R_0603_1608Metric; Mouser Part Number 71-CRCW060310K0FKEI
U9, U10: SN74HC594DR; SOIC127P600X175-16N; LCSC C91727

Connections:
+3.3V: C34.1, C35.1, R61.1, R62.1, U9.16 (VCC), U10.16 (VCC)
GND: C24.2, C25.2, C34.2, C35.2, D14.1 (K), D15.1 (K), D16.1 (K), D17.1 (K), D18.1 (K), D19.1 (K), D20.1 (K), D21.1 (K), D22.1 (K), D23.1 (K), D24.1 (K), D25.1 (K), D26.1 (K), D28.1 (K), D29.1 (K), D30.1 (K), U9.8 (GND), U10.8 (GND)
LED_RCLK: U9.12 (RCLK), U10.12 (RCLK)
LED_SER: U9.14 (SER)
LED_SRCLK: U9.11 (SRCLK), U10.11 (SRCLK)
unnamed: C24.1, R61.2, U9.10 (~SRCLR), U9.13 (~RCLR)
unnamed: C25.1, R62.2, U10.10 (~SRCLR), U10.13 (~RCLR)
unnamed: D14.2 (A), R42.2
unnamed: D15.2 (A), R43.2
unnamed: D16.2 (A), R46.2
unnamed: D17.2 (A), R47.2
unnamed: D18.2 (A), R48.2
unnamed: D19.2 (A), R49.2
unnamed: D20.2 (A), R50.2
unnamed: D21.2 (A), R52.2
unnamed: D22.2 (A), R53.2
unnamed: D23.2 (A), R54.2
unnamed: D24.2 (A), R55.2
unnamed: D25.2 (A), R56.2
unnamed: D26.2 (A), R57.2
unnamed: D28.2 (A), R59.2
unnamed: D29.2 (A), R60.2
unnamed: D30.2 (A), R58.2
unnamed: R42.1, U9.15 (QA)
unnamed: R43.1, U9.1 (QB)
unnamed: R46.1, U9.2 (QC)
unnamed: R47.1, U9.3 (QD)
unnamed: R48.1, U9.4 (QE)
unnamed: R49.1, U9.5 (QF)
unnamed: R50.1, U9.6 (QG)
unnamed: R52.1, U9.7 (QH)
unnamed: R53.1, U10.15 (QA)
unnamed: R54.1, U10.1 (QB)
unnamed: R55.1, U10.2 (QC)
unnamed: R56.1, U10.3 (QD)
unnamed: R57.1, U10.4 (QE)
unnamed: R58.1, U10.5 (QF)
unnamed: R59.1, U10.6 (QG)
unnamed: R60.1, U10.7 (QH)
unnamed: U9.9 (QH'), U10.14 (SER)
