lhr-solar/BPS-Leader/Hardware/POWER.kicad_sch

## KiCad design Hardware/POWER.kicad_sch (2026-01-18)

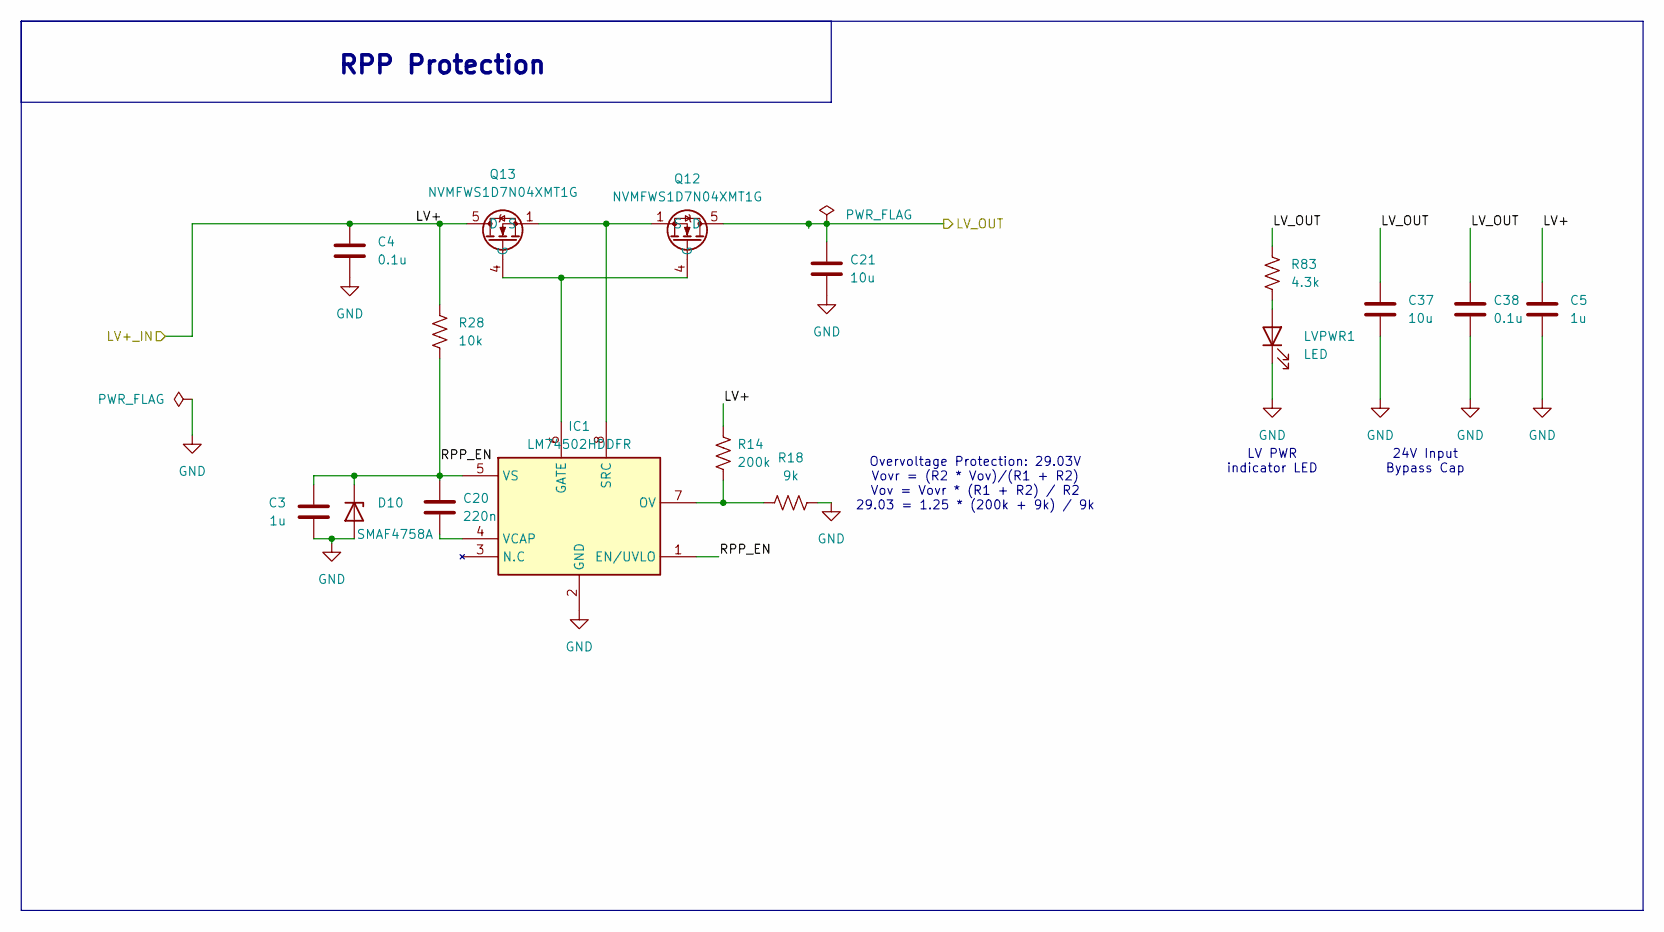
[picture p12: schematic POWER.kicad_sch]

Parts:
C3: 1u; C_0603_1608Metric; Mouser Part Number 963-UMK107BJ105KA-T
C4, C38: 0.1u; C_0603_1608Metric; Mouser Part Number 963-HMK107B7104KA-T
C5: 1u; C_0603_1608Metric; Mouser Part Number 963-HMK107B7104KA-T
C20: 220n; C_0603_1608Metric; Mouser Part Number 963-MSASU168SB7224KT
C21, C37: 10u; C_0805_2012Metric; Mouser Part Number 81-GRM21BR61H106KE3K
D10: SMAF4758A; SODFL4724X108N; LCSC C183490
IC1: LM74502HDDFR; SOT65P280X110-8N; Mouser Part Number 595-LM74502HDDFR
LVPWR1: LED; LED_0603_1608Metric; LCSC C7371904
Q12, Q13: NVMFWS1D7N04XMT1G; NVMFWS3D0P04M8LT1G; LCSC C133142
R14: 200k; R_0603_1608Metric; Mouser Part Number 594-MCT06030C2003FP5
R18: 9k; R_0603_1608Metric; Mouser Part Number 594-MCT06030C9091FP5
R28: 10k; R_0603_1608Metric; Mouser Part Number 71-CRCW060310K0FKEI
R83: 4.3k; R_0603_1608Metric; Mouser Part Number 71-CRCW060310K0FKEI

Connections:
GND: C3.1, C4.2, C5.2, C21.2, C37.2, C38.2, D10.2 (A), IC1.2 (GND), LVPWR1.1 (K), R18.2
LV+: C4.1, C5.1, Q13.5 (D), Q13.6 (D), Q13.7 (D), Q13.8 (D), Q13.9 (D), R14.1, R28.1
LV_OUT: C21.1, C37.1, C38.1, Q12.5 (D), Q12.6 (D), Q12.7 (D), Q12.8 (D), Q12.9 (D), R83.1
unnamed: C20.2, IC1.4 (VCAP)
unnamed: IC1.6 (GATE), Q12.4 (G), Q13.4 (G)
unnamed: IC1.7 (OV), R14.2, R18.1
unnamed: IC1.8 (SRC), Q12.1 (S), Q12.2 (S), Q12.3 (S), Q13.1 (S), Q13.2 (S), Q13.3 (S)
unnamed: LVPWR1.2 (A), R83.2
RPP_EN: C3.2, C20.1, D10.1 (K), IC1.1 (EN/UVLO), IC1.5 (VS), R28.2

Notes on the sheet:
Overvoltage Protection: 29.03V Vovr = (R2 * Vov)/(R1 + R2) Vov = Vovr * (R1 + R2) / R2 29.03 = 1.25 * (200k + 9k) / 9k
24V Input Bypass Cap
RPP Protection
LV PWR indicator LED
