lhr-solar/BPS-Leader/Hardware/contactor_control_sense.kicad_sch

## KiCad design Hardware/contactor_control_sense.kicad_sch (2026-01-18)

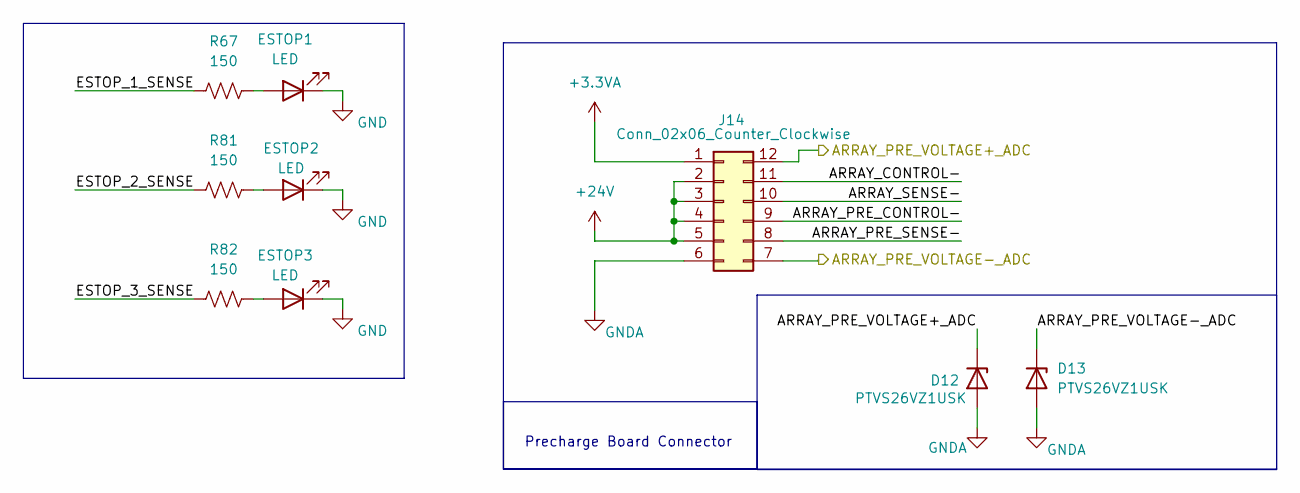
[picture p13: schematic contactor_control_sense.kicad_sch]

Parts:
D12, D13: PTVS26VZ1USK; Nexperia_DSN1608-2_1.6x0.8mm
ESTOP1, ESTOP2, ESTOP3: LED; LED_0603_1608Metric
J14: Conn_02x06_Counter_Clockwise; Molex_Nano-Fit_105310-xx12_2x06_P2.50mm_Vertical
R67, R81, R82: 150; R_0603_1608Metric

Connections:
+3.3VA: J14.1
+24V: J14.2, J14.3, J14.4, J14.5
ARRAY_CONTROL-: J14.11
ARRAY_PRE_CONTROL-: J14.9
ARRAY_PRE_SENSE-: J14.8
ARRAY_PRE_VOLTAGE+_ADC: D12.1 (K), J14.12
ARRAY_PRE_VOLTAGE-_ADC: D13.1 (K), J14.7
ARRAY_SENSE-: J14.10
ESTOP_1_SENSE: R67.1
ESTOP_2_SENSE: R81.1
ESTOP_3_SENSE: R82.1
GND: ESTOP1.1 (K), ESTOP2.1 (K), ESTOP3.1 (K)
GNDA: D12.2 (A), D13.2 (A), J14.6
unnamed: ESTOP1.2 (A), R67.2
unnamed: ESTOP2.2 (A), R81.2
unnamed: ESTOP3.2 (A), R82.2

Notes on the sheet:
Precharge Board Connector
