lhr-solar/BPS-Leader/Hardware/Hardware.ioc

Mcu.UserName=STM32G473RETx
PA0.Signal=GPIO_Input
PA1.Signal=GPIO_Input
PA10.Signal=GPIO_Input
PA11.Signal=FDCAN1_RX
PA12.Signal=FDCAN1_TX
PA13.Signal=SYS_JTMS-SWDIO
PA14.Signal=SYS_JTCK-SWCLK
PA15.Signal=FDCAN3_TX
PA2.Signal=GPIO_Input
PA8.Signal=FDCAN3_RX
PB0.Signal=GPIO_Output
PB1.Signal=GPIO_Input
PB10.Signal=LPUART1_RX
PB11.Signal=LPUART1_TX
PB12.Signal=ADC1_IN11
PB13.Signal=GPIO_Output
PB14.Signal=GPIO_Output
PB15.Signal=GPIO_Output
PB2.Signal=ADC2_IN12
PB3.Signal=GPIO_Input
PB4.Signal=GPIO_Input
PB5.Signal=GPIO_Input
PB9.Signal=GPIO_Output
PC0.Signal=GPIO_Input
PC1.Signal=GPIO_Output
PC12.Signal=GPIO_Output
PC2.Signal=GPIO_Output
PC3.Signal=GPIO_Output
PC6.Signal=I2C4_SCL
PC7.Signal=I2C4_SDA
PC8.Signal=I2C3_SCL
PC9.Signal=I2C3_SDA
PD2.Signal=GPIO_Output
PF0-OSC_IN.Signal=RCC_OSC_IN
PF1-OSC_OUT.Signal=RCC_OSC_OUT
