lhr-solar/BPS-Leader/Software/Tasks/Src/FanControllerTask.c

#include "common.h"
#include "BPS_Tasks.h"
#include "EMC2305_Driver.h"



void Task_Fan_Controller() {

    TickType_t xLastWakeTime = xTaskGetTickCount();

    while (1)
    {

        vTaskDelayUntil(&xLastWakeTime, pdMS_TO_TICKS(FAN_CONTROLLER_TASK_DELAY_MS));

        // sets rpm of fans to 1500
        set_fan_rpm(EMC2305_FAN1, 1500);
        set_fan_rpm(EMC2305_FAN2, 1500);
    }
}
