lhr-solar/BPS-Leader/Software/Config/Inc/can1_recv_entries.h

#include "BPSCAN_can_msgs.h"
#include "CarCAN_can_msgs.h"

// CAN_RECV_ENTRY(ID, SIZE, CIRCULAR)
    
CAN_RECV_ENTRY(CAN_ID_BPS_VT0_VOLTAGE_ARR, CAN_DLC_BPS_VT0_VOLTAGE_ARR, true)
CAN_RECV_ENTRY(CAN_ID_BPS_VT1_VOLTAGE_ARR, CAN_DLC_BPS_VT1_VOLTAGE_ARR, true)
CAN_RECV_ENTRY(CAN_ID_BPS_VT2_VOLTAGE_ARR, CAN_DLC_BPS_VT2_VOLTAGE_ARR, true)
CAN_RECV_ENTRY(CAN_ID_BPS_VT3_VOLTAGE_ARR, CAN_DLC_BPS_VT3_VOLTAGE_ARR, true)
CAN_RECV_ENTRY(CAN_ID_BPS_VT4_VOLTAGE_ARR, CAN_DLC_BPS_VT4_VOLTAGE_ARR, true)
CAN_RECV_ENTRY(CAN_ID_BPS_VT5_VOLTAGE_ARR, CAN_DLC_BPS_VT5_VOLTAGE_ARR, true)
CAN_RECV_ENTRY(CAN_ID_BPS_VT6_VOLTAGE_ARR, CAN_DLC_BPS_VT6_VOLTAGE_ARR, true)
CAN_RECV_ENTRY(CAN_ID_BPS_VT7_VOLTAGE_ARR, CAN_DLC_BPS_VT7_VOLTAGE_ARR, true)
CAN_RECV_ENTRY(CAN_ID_BPS_PACK_CURRENT, CAN_DLC_BPS_PACK_CURRENT, true)
CAN_RECV_ENTRY(CAN_ID_BPS_VT0_TEMPERATURE_ARR, CAN_DLC_BPS_VT0_TEMPERATURE_ARR, true)
CAN_RECV_ENTRY(CAN_ID_BPS_VT1_TEMPERATURE_ARR, CAN_DLC_BPS_VT1_TEMPERATURE_ARR, true)
CAN_RECV_ENTRY(CAN_ID_BPS_VT2_TEMPERATURE_ARR, CAN_DLC_BPS_VT2_TEMPERATURE_ARR, true)
CAN_RECV_ENTRY(CAN_ID_BPS_VT3_TEMPERATURE_ARR, CAN_DLC_BPS_VT3_TEMPERATURE_ARR, true)
CAN_RECV_ENTRY(CAN_ID_BPS_VT4_TEMPERATURE_ARR, CAN_DLC_BPS_VT4_TEMPERATURE_ARR, true)
CAN_RECV_ENTRY(CAN_ID_BPS_VT5_TEMPERATURE_ARR, CAN_DLC_BPS_VT5_TEMPERATURE_ARR, true)
CAN_RECV_ENTRY(CAN_ID_BPS_VT6_TEMPERATURE_ARR, CAN_DLC_BPS_VT6_TEMPERATURE_ARR, true)
CAN_RECV_ENTRY(CAN_ID_BPS_VT7_TEMPERATURE_ARR, CAN_DLC_BPS_VT7_TEMPERATURE_ARR, true)
