lhr-solar/BPS-Leader/Software/Tests/temp_monitor_test.c

#include "BPS_Tasks.h"
#include "StatusLEDs.h"
#include "Contactors.h"
#include "CANbus.h"
#include "BPSCAN_can_msgs.h"
#include "SHT45.h"
#include "DebugPrintf.h"
#include "EMC2305_Driver.h"

#define BLINKY_TASK_STACK_SIZE configMINIMAL_STACK_SIZE
#define BLINKY_TASK_PRIORITY (tskIDLE_PRIORITY + 1)

#define DELAY_1S pdMS_TO_TICKS(1000)

typedef struct {
    uint8_t BPS_Tap_idx;
    uint8_t BPS_Temperature_Tap_Fault;
    int32_t BPS_Temperature_Tap_Data;
    uint16_t BPS_Temperature_Tap_RawV;
} bps_temperature_arr_t;

// Static task buffers
static StaticTask_t xBlinkyTaskBuffer;
static StackType_t xBlinkyStack[BLINKY_TASK_STACK_SIZE];


StaticTask_t xTestTaskBuffer;
StackType_t xTestStack[TEST_TASK_STACK_SIZE];

// blink
void vBlinkyTask(void *pvParameters)
{
    while (true)
    {
        toggleHeartbeat();
        vTaskDelay(DELAY_1S);
    }
}

static const uint8_t temp_id_mask = 0x1F;
static const uint8_t fault_mask = 0xE0;

/**
 * @brief Packs a bps_temperature_arr_t struct into a raw CAN data buffer.
 * * @param raw_temp_can_data Pointer to the 8-byte (or DLC size) buffer to fill.
 * @param temp_can_data Pointer to the source struct containing the tap data.
 */
static void temp_can_pack(uint8_t *raw_temp_can_data, const bps_temperature_arr_t *temp_can_data)
{

    if (raw_temp_can_data == NULL || temp_can_data == NULL)
    {
        return;
    }

    // Clear the buffer first to ensure no old data remains
    // Assuming the DLC is 4 based on your unpack logic
    for (int i = 0; i < 4; i++)
        raw_temp_can_data[i] = 0;

    // Byte 0: Tap Index & fault (Applying the mask to ensure it doesn't bleed into other bits)
    raw_temp_can_data[0] = (temp_can_data->BPS_Tap_idx & temp_id_mask) | (temp_can_data->BPS_Temperature_Tap_Fault & fault_mask);

    // Byte 1: Temperature Low Byte (Least Significant Byte)
    raw_temp_can_data[1] = (uint8_t)(temp_can_data->BPS_Temperature_Tap_Data & 0xFF);

    // Byte 2: Temperature High Byte (Most Significant Byte)
    raw_temp_can_data[2] = (uint8_t)((temp_can_data->BPS_Temperature_Tap_Data >> 8) & 0xFF);

    raw_temp_can_data[3] = (uint8_t)((temp_can_data->BPS_Temperature_Tap_Data >> 16) & 0xFF);

    raw_temp_can_data[4] = (uint8_t)((temp_can_data->BPS_Temperature_Tap_Data >> 24) & 0xFF);

    // garbage data (shouldn't appear in temp monitering task)
    raw_temp_can_data[5] = (uint8_t)(0x45);
    raw_temp_can_data[6] = (uint8_t)(0x68);
}

void vFakeTempSend(void *pvParameters)
{

    vTaskDelay(pdMS_TO_TICKS(250));

    bps_temperature_arr_t message_struct = {
        .BPS_Tap_idx = 0,
        .BPS_Temperature_Tap_Data = 0,
        .BPS_Temperature_Tap_Fault = 0};

    uint8_t can_id = CAN_ID_BPS_VT0_TEMPERATURE_ARR;

    uint8_t can_message[CAN_DLC_BPS_VT0_TEMPERATURE_ARR];

    while (true)
    {

        vTaskDelay(pdMS_TO_TICKS(TEMP_MONITOR_TASK_DELAY_MS) / 32);

        temp_can_pack(can_message, &message_struct);

        car_can_send(can_id, can_message, CAN_DLC_BPS_VT0_TEMPERATURE_ARR, 10);

        (message_struct.BPS_Tap_idx == 31) ? (message_struct.BPS_Tap_idx = 0) : message_struct.BPS_Tap_idx++;

        can_id = message_struct.BPS_Tap_idx / 4 + CAN_ID_BPS_VT0_TEMPERATURE_ARR;

        message_struct.BPS_Temperature_Tap_Data = (message_struct.BPS_Temperature_Tap_Data >= OVERTEMP_THRESHOLD_CHARGING_MC - 10) ? 0 : message_struct.BPS_Temperature_Tap_Data + 10;
    }
}

int main()
{
    // Initialize the contactor hardware and software abstractions

    HAL_Init();

    SystemClock_Config();

    CAN_Init();
    
    LEDs_init();

    contactor_init();

    SHT45_init();

    EMC2305_Driver_init();

    debugPrintf_init();

    Init_WDogTask();

    printf("Initialized\n\r");

    xStateBits = xEventGroupCreateStatic(&xStateBits_buffer);

    xTaskCreateStatic(
        vFakeTempSend,
        "Fake Temperature Measurements",
        TEST_TASK_STACK_SIZE,
        NULL,
        TEST_TASK_PRIORITY,
        xTestStack,
        &xTestTaskBuffer);

    xTaskCreateStatic(
        Task_FaultHandler,             // Task function
        "FaultHandler",                // Name of the task (for debugging)
        FAULT_HANDLER_TASK_STACK_SIZE,   // Stack size in words
        (void*)NULL,                       // Task input parameter
        TASK_FAULT_HANDLER_PRIO,       // Task priority
        FaultHandler_Task_Stack,       // Task handle
        &FaultHandler_Task_Buffer      // Static task buffer (optional)
    );

    xTaskCreateStatic(
        Task_Temperature_Monitor,
        "Temperature Task",
        TASK_TEMPERATURE_MONITOR_STACK_SIZE,
        NULL,
        TASK_TEMPERATURE_MONITOR_PRIO,
        Task_Temperature_Stack_Array,
        &Task_Temperature_Buffer);

    xTaskCreateStatic(
        vBlinkyTask,
        "Blinky",
        BLINKY_TASK_STACK_SIZE,
        NULL,
        BLINKY_TASK_PRIORITY,
        xBlinkyStack,
        &xBlinkyTaskBuffer);

    vTaskStartScheduler();

    return 0;
}
