lhr-solar/BPS-Leader/(commit log)

2024-10-26 initial makefile review (#1)
    * initial commit: empty makefile
    * embedded-sharepoint compiles with make
    * actually compiles embedded sharepoint now
    * improved makefile
    * added clean in Makefile
    * better clean
    * builds? production code
    * builds with test file, error with main
    * compiles test (jolly good)
    * builds both main & test (but it's hardcoded)
    * everything seems to compile properly (compiling for test now excludes main.c)
    * improved "make help"; everything compiles
    * test folder
    * added header file
    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
    [main.c]
2025-02-07 BPS Leader Code Structure (#2)
    * started adding structure
    * started messing with Readme
    * wahooo
    * addded config
    * started task stuff
    * still messing with stuff
    * dumbass
    * fixed some stuff
    * who needs to test code
    * works on nucleo, yipeeeee
    * started testing tasks
    * the OS is not OSing
    * init task doesn't brick itself
    * yahoo and such
    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
    [BPS_Tasks.h, InitTask.c, config.h, main.c]
2025-03-02 IWDG (#4)
    * first IDWG draft
    * modified makefile to allow passed-in stm targets
    * end of day 11/2 commit
    * restructure
    * fixed flash for my makefile
    * fixed ghot spaces in default project target
    * end of workday commit (11/9/24)
    * confirmed flash to nucleo, IWDG continuosly resets though
    * IWDG refreshes in time, but with funky timeout
    * documented some issues
    * IWDG seems to work
    * end of workday 11/16/24 commit
    * end of workday 12/7/24
    * changed c_cpp properties
    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
    [BPS_Tasks.h, IWDG.c, IWDG.h, InitTask.c, PetWatchdogTask.c, main.c]
2025-10-30 Rev A (#12)
    * hi
    * inital
    * BPS-Leader Schematic completed (mostly)
    * Confirmed ESP pin UART Boot-capability, labeled LED's, Moved Power sheet to a nicer location
    * removed useless txt file
    * Completely remove KiCAD-Sharepoint
    * added fuse, made kiCad Sharepoint a submodule, added a pulldown, added test-points
    * removed redundant .ioc
    * Small tweaks
    * Very, very intial layout designed. Many issues. Too bad!
    * small fixes
    * moved the 24V test point out from under the LSOM
    * Fixed DRC violations, added missing PTC Fuse
    * Redid layout, still missed STEP Files
    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
    [105309-1204.stp, 105309-1303.stp, 105310-1112.stp, 3568.step, 3568.stp, BPS-Leader.csv, BPS-Leader.kicad_sch, Buttond_LEDs_IO.kicad_sch]
2026-01-18 RevB PR (#14)
    * RevB Schematic Update
    * RevB Schematic revisions
    * revB updates
    * Schematic polishes, layout WIP
    * circuit blocks designed, schematic updated
    * unblocked SD card holder
    * halfway laid-out
    * unblocked SD card again
    * small schematic changes
    * intial layout design
    * Updated LSOM footprint
    * filled in copper holes. Name/REV/Date added
    * RevB layout completed
    * JLC Production Files
    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
    [105309-1204.stp, 105309-1303.stp, 105310-1112.stp, 3568.step, 3568.stp, ArrPreContactor.kicad_sch, Arr_Contactor.kicad_sch, BOM-BPS-Leader.csv]
2026-03-28 Drivers (#15)
    * initial commit
    * added embedded sharepoint submodule
    * TmpHmd
    * Added more drivers
    * fixed code from comments, makefile fixes
    * review changes made
    * added docs
    * pinout FIXED for RevB
    * Fixed everything
    * added new tests
    * review changes made
    * completed I2C test function
    * driver overhaul
    * fixed compile errors
    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
    [ADC_Array_LUT.h, ADC_Battery_LUT.h, ADC_Driver.c, ADC_Driver.h, ADC_test.c, BPSCAN_can_msgs.h, BPS_Tasks.h, CANbus.c]
2026-04-05 Amperes Task (#17)
    * amepres task draft
    * amperes task running with fault handler, no watchdog yet
    * removed HB toggle, reverted some files
    * can recv entries
    ---------
    [AmperesMonitorTask.c, BPSCAN_can_msgs.h, BPS_Tasks.h, CarCAN_can_msgs.h, FaultHandlerTask.c, amperes_test.c, can1_recv_entries.h]
2026-06-13 BPSL Task Logic (#16)
    * Volt moniter task
    * voltage task works (still refining)
    * added temp monitor
    * temp monitoring test
    * removed fake test
    * amperes monitor task
    * add can forward to initTask and implement voltage aggregate packing
    * fix minor bugs in voltage packing
    * fixed build
    * addressed comments (except fan task)
    * addressed gemini comments
    * fixed gemini comments again (commit farming)
    * gamebreaking bug fixed
    * addressed reviews
    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
    [AmperesMonitorTask.c, BPSCAN_can_msgs.h, BPS_Tasks.h, CANbus.c, CanForwardingTask.c, CanStatusTask.c, CarCAN_can_msgs.h, ContactorMonitoringTask.c]
2026-06-19 Temperature Fault Histogram + Update Sharepoint to 489ea138 (#24)
    * removed error callback in canbus.c in favor of sharepoint callback
    * add temp fault histogram
    * add static assert to prevent overflowing otemp fault counter
    [CANbus.c, TempatureMonitoringTask.c, config.h]
2026-07-07 fixed can_fd_rx_callback typo in can forwarding
    [CanForwardingTask.c]
